sparkfunX/MicroMod_Thing_Plus/Hardware/Production/ordering_instructions.txt

panel size, 205x131mm
PCB thickness, 1.6mm
number of layers, 4
soldermask color, Black
silkscreen color, White
oz copper, 1oz
finish, HASL lead free
stencils, none
pcs per panel, 10
min trace width, 0.1778mm / 0.0070in
min drill size, 0.3048mm / 0.0120in
filename to layer stackup 1/2/3/4: GTL, GL2, GL3, GBL
