sparkfunX/MicroMod_Thing_Plus/Hardware/Jig/ThingPlus_Micromod-BottomJig.brd

## EAGLE design Hardware/Jig/ThingPlus_Micromod-BottomJig.brd (2021-07-26)

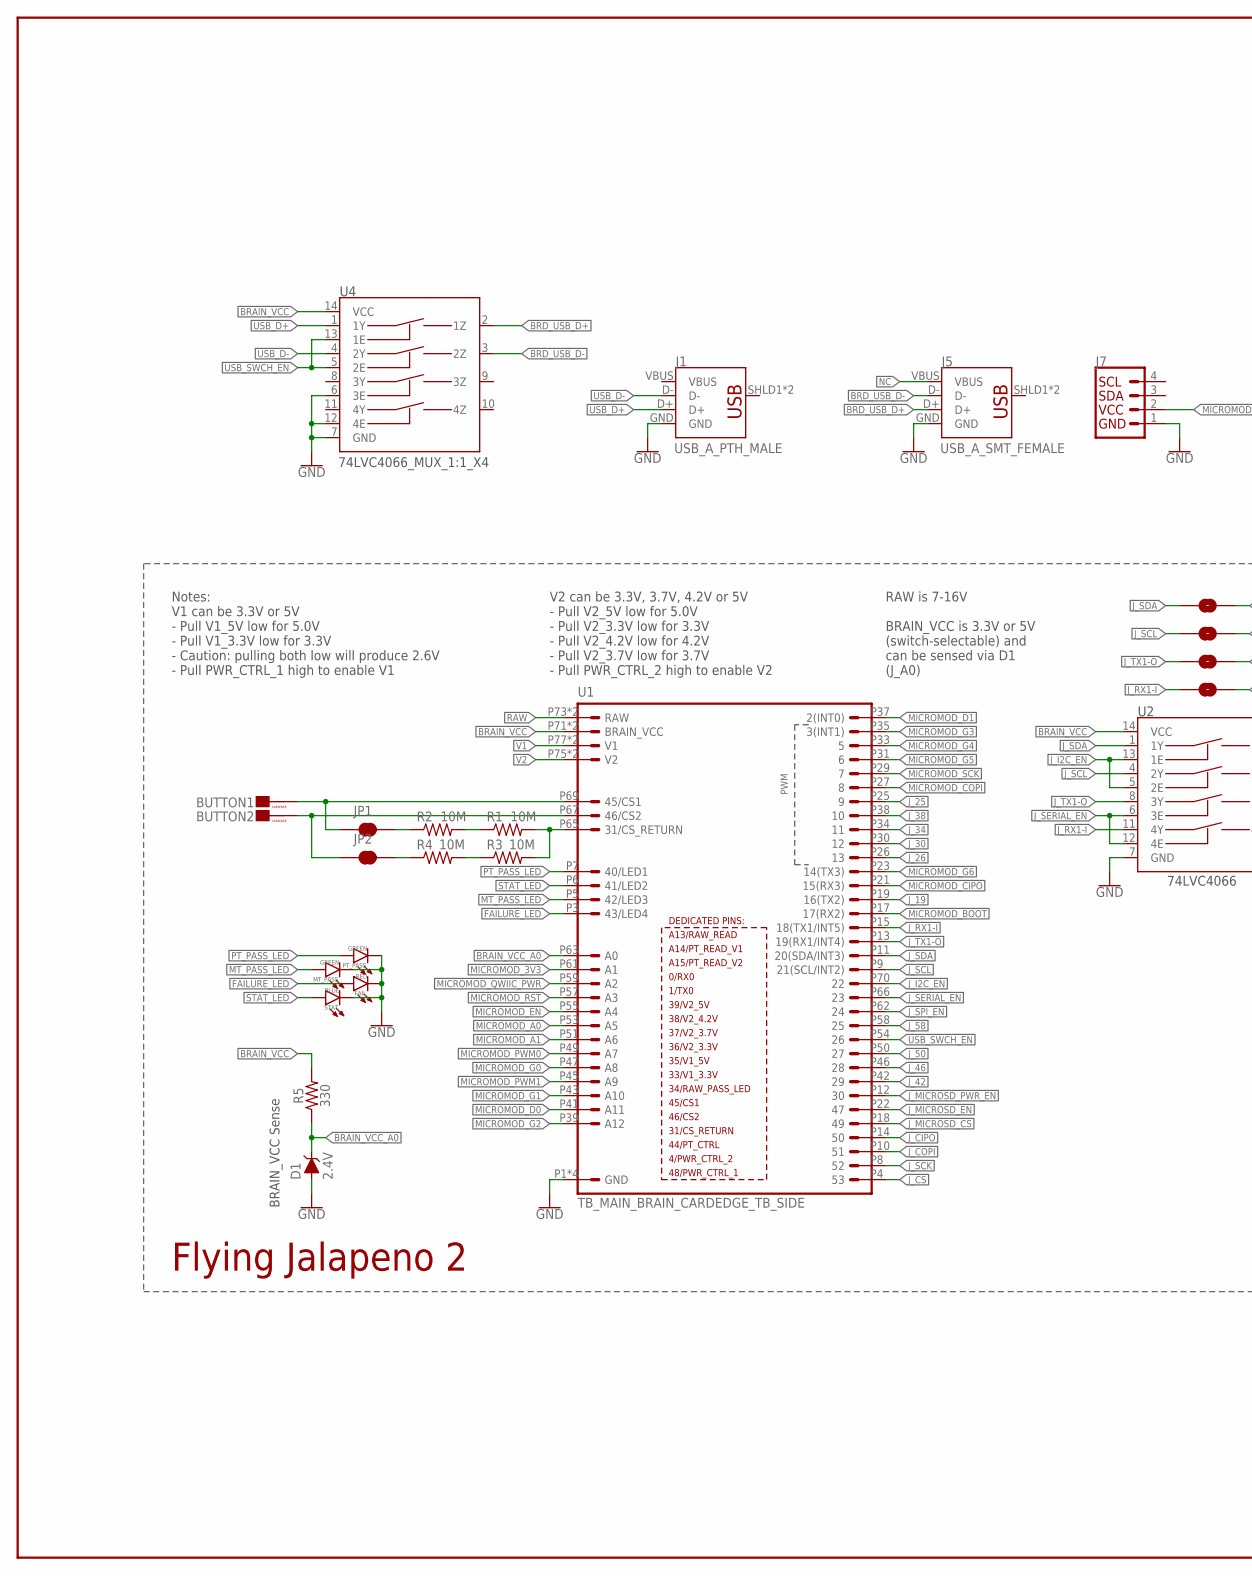
[picture p1: schematic ThingPlus_Micromod-BottomJig.sch, part in row 1, column 1]

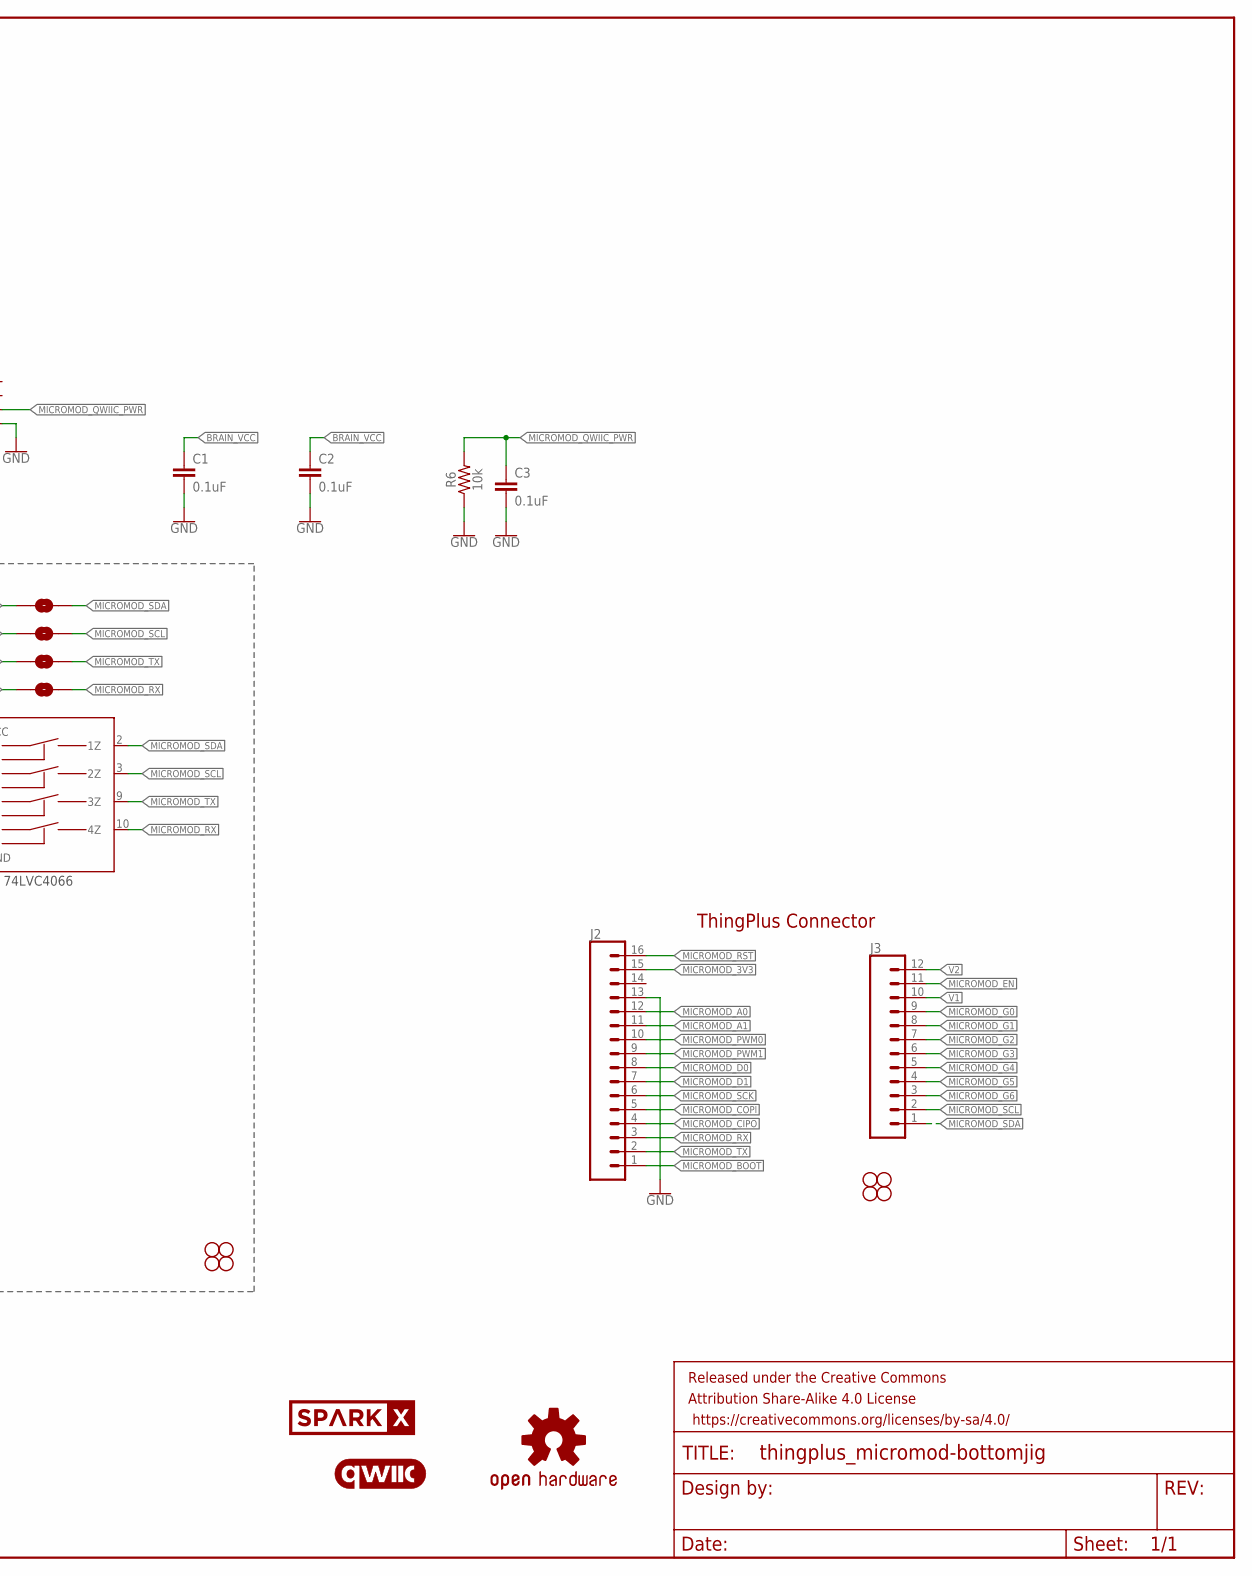
[picture p2: schematic ThingPlus_Micromod-BottomJig.sch, part in row 1, column 2]

Parts:
BUTTON1, BUTTON2: CAPSENSE_BUTTON_PAD_ONLYV2_SMALL; CAPSENSE_BUTTON_PAD_ONLY_SM
C1, C2, C3: 0.1uF; 0603
D1: 2.4V; SOD-323
FAIL: RED; LED-1206
FRAME2: FRAME-LEDGER; CREATIVE_COMMONS
H1, H2, H3, H4, H5, H6, H7, H8: STAND-OFF
J1: USB_A_PTH_MALE; USB-A-H
J2: CONN_161X16_SM_SQ_NOSILK; 1X16_SM_SQ_NOSILK
J3: CONN_12SM_SQ_NO_SILK; 1X12_SM_SQ_NOSILK
J5: USB_A_SMT_FEMALE; USB-A-S-SILK-FEMALE
J7: QWIIC_RIGHT_ANGLE; JST04_1MM_RA
JP1, JP2: JUMPER-SMT_2_NC_TRACE_SILK; SMT-JUMPER_2_NC_TRACE_SILK
J_SCL, J_SCL1, J_SCL2: JUMPER-SMT_2_NO_SILK; SMT-JUMPER_2_NO_SILK
J_SDA: JUMPER-SMT_2_NO_SILK; SMT-JUMPER_2_NO_SILK
LOGO2: OSHW-LOGOMINI; OSHW-LOGO-MINI
LOGO4: QWIIC_LOGO_4MM; QWIIC_4MM
MT_PASS: GREEN; LED-1206
PT_PASS: GREEN; LED-1206
R1, R2, R3, R4: 10M; 0603
R5: 330; 0603
R6: 10k; 0603
STAT: BLUE; LED-1206
U1: TB_MAIN_BRAIN_CARDEDGE_TB_SIDE; TB_CARDEDGE
U2: 74LVC4066; SO14
U4: 74LVC4066_MUX_1:1_X4; SO14
U$1: SPARKX-LOGO4; SPARKX-MEDIUM

Connections:
!MICROMOD_BOOT!: J2.1, U1.P17 (17(RX2))
!MICROMOD_RST!: J2.16, U1.P57 (A3)
BRAIN_VCC: C1.1, C2.1, R5.2, U1.P71 (BRAIN_VCC), U1.P72 (BRAIN_VCC), U2.14 (VCC), U4.14 (VCC)
BRAIN_VCC_A0: D1.C, R5.1, U1.P63 (A0)
BRD_USB_D+: J5.D+, U4.2 (1Z)
BRD_USB_D-: J5.D-, U4.3 (2Z)
FAILURE_LED: FAIL.A, U1.P3 (43/LED4)
GND: C1.2, C2.2, C3.2, D1.A, FAIL.C, J1.GND, J2.13, J5.GND, J7.1, MT_PASS.C, PT_PASS.C, R6.1, STAT.C, U1.P1 (GND), U1.P2 (GND), U1.P79 (GND), U1.P80 (GND), U2.7 (GND), U4.6 (3E), U4.7 (GND), U4.12 (4E)
J_19: U1.P19 (16(TX2))
J_25: U1.P25 (9)
J_26: U1.P26 (13)
J_30: U1.P30 (12)
J_34: U1.P34 (11)
J_38: U1.P38 (10)
J_42: U1.P42 (29)
J_46: U1.P46 (28)
J_50: U1.P50 (27)
J_58: U1.P58 (25)
J_CIPO: U1.P14 (50)
J_COPI: U1.P10 (51)
J_CS: U1.P4 (53)
J_I2C_EN: U1.P70 (22), U2.5 (2E), U2.13 (1E)
J_MICROSD_!CS!: U1.P18 (49)
J_MICROSD_EN: U1.P22 (47)
J_MICROSD_PWR_EN: U1.P12 (30)
J_RX1-I: J_SDA.1, U1.P15 (18(TX1/INT5)), U2.11 (4Y)
J_SCK: U1.P8 (52)
J_SCL: J_SCL.1, U1.P9 (21(SCL/INT2)), U2.4 (2Y)
J_SDA: J_SCL2.1, U1.P11 (20(SDA/INT3)), U2.1 (1Y)
J_SERIAL_EN: U1.P66 (23), U2.6 (3E), U2.12 (4E)
J_SPI_EN: U1.P62 (24)
J_TX1-O: J_SCL1.1, U1.P13 (19(RX1/INT4)), U2.8 (3Y)
MICROMOD_3V3: J2.15, U1.P61 (A1)
MICROMOD_A0: J2.12, U1.P53 (A5)
MICROMOD_A1: J2.11, U1.P51 (A6)
MICROMOD_CIPO: J2.4, U1.P21 (15(RX3))
MICROMOD_COPI: J2.5, U1.P27 (8)
MICROMOD_D0: J2.8, U1.P41 (A11)
MICROMOD_D1: J2.7, U1.P37 (2(INT0))
MICROMOD_EN: J3.11, U1.P55 (A4)
MICROMOD_G0: J3.9, U1.P47 (A8)
MICROMOD_G1: J3.8, U1.P43 (A10)
MICROMOD_G2: J3.7, U1.P39 (A12)
MICROMOD_G3: J3.6, U1.P35 (3(INT1))
MICROMOD_G4: J3.5, U1.P33 (5)
MICROMOD_G5: J3.4, U1.P31 (6)
MICROMOD_G6: J3.3, U1.P23 (14(TX3))
MICROMOD_PWM0: J2.10, U1.P49 (A7)
MICROMOD_PWM1: J2.9, U1.P45 (A9)
MICROMOD_QWIIC_PWR: C3.1, J7.2, R6.2, U1.P59 (A2)
MICROMOD_RX: J2.3, J_SDA.2, U2.10 (4Z)
MICROMOD_SCK: J2.6, U1.P29 (7)
MICROMOD_SCL: J3.2, J_SCL.2, U2.3 (2Z)
MICROMOD_SDA: J3.1, J_SCL2.2, U2.2 (1Z)
MICROMOD_TX: J2.2, J_SCL1.2, U2.9 (3Z)
MT_PASS_LED: MT_PASS.A, U1.P5 (42/LED3)
unnamed: R1.2, R3.2, U1.P65 (31/CS_RETURN)
unnamed: R1.1, R2.2
unnamed: BUTTON1.CAPSENSE_PAD, JP1.1, U1.P69 (45/CS1)
unnamed: R3.1, R4.2
unnamed: JP2.2, R4.1
unnamed: BUTTON2.CAPSENSE_PAD, JP2.1, U1.P67 (46/CS2)
unnamed: JP1.2, R2.1
NC: J5.VBUS
PT_PASS_LED: PT_PASS.A, U1.P7 (40/LED1)
RAW: U1.P73 (RAW), U1.P74 (RAW)
STAT_LED: STAT.A, U1.P6 (41/LED2)
USB_D+: J1.D+, U4.1 (1Y)
USB_D-: J1.D-, U4.4 (2Y)
USB_SWCH_EN: U1.P54 (26), U4.5 (2E), U4.13 (1E)
V1: J3.10, U1.P77 (V1), U1.P78 (V1)
V2: J3.12, U1.P75 (V2), U1.P76 (V2)
VBUS: J1.VBUS

Notes on the sheet:
ThingPlus Connector
Flying Jalapeno 2
Notes: V1 can be 3.3V or 5V - Pull V1_5V low for 5.0V - Pull V1_3.3V low for 3.3V - Caution: pulling both low will produce 2.6V - Pull PWR_CTRL_1 high to enable V1
V2 can be 3.3V, 3.7V, 4.2V or 5V - Pull V2_5V low for 5.0V - Pull V2_3.3V low for 3.3V - Pull V2_4.2V low for 4.2V - Pull V2_3.7V low for 3.7V - Pull PWR_CTRL_2 high to enable V2
RAW is 7-16V BRAIN_VCC is 3.3V or 5V (switch-selectable) and can be sensed via D1 (J_A0)
BRAIN_VCC Sense

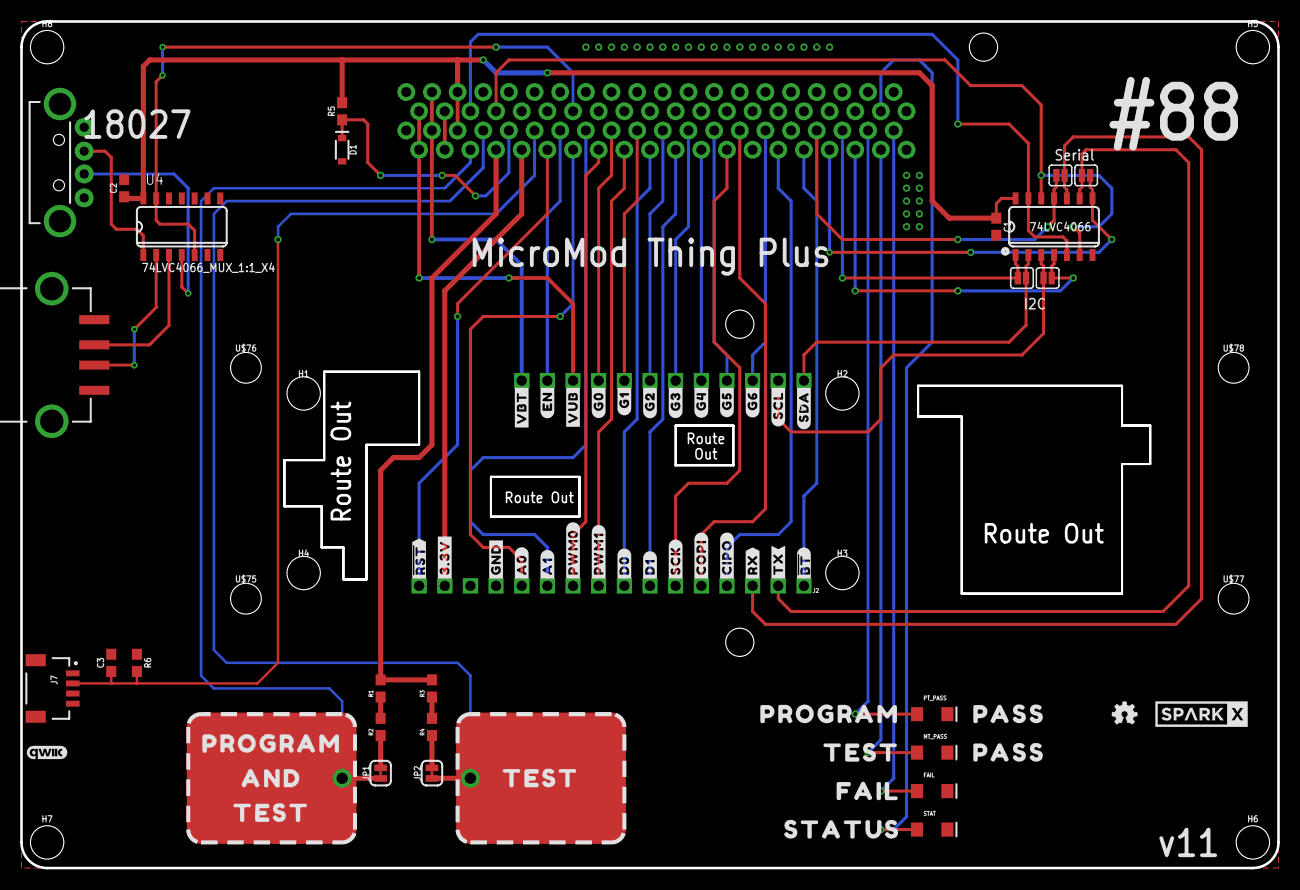
[picture p3: board ThingPlus_Micromod-BottomJig.brd from above]

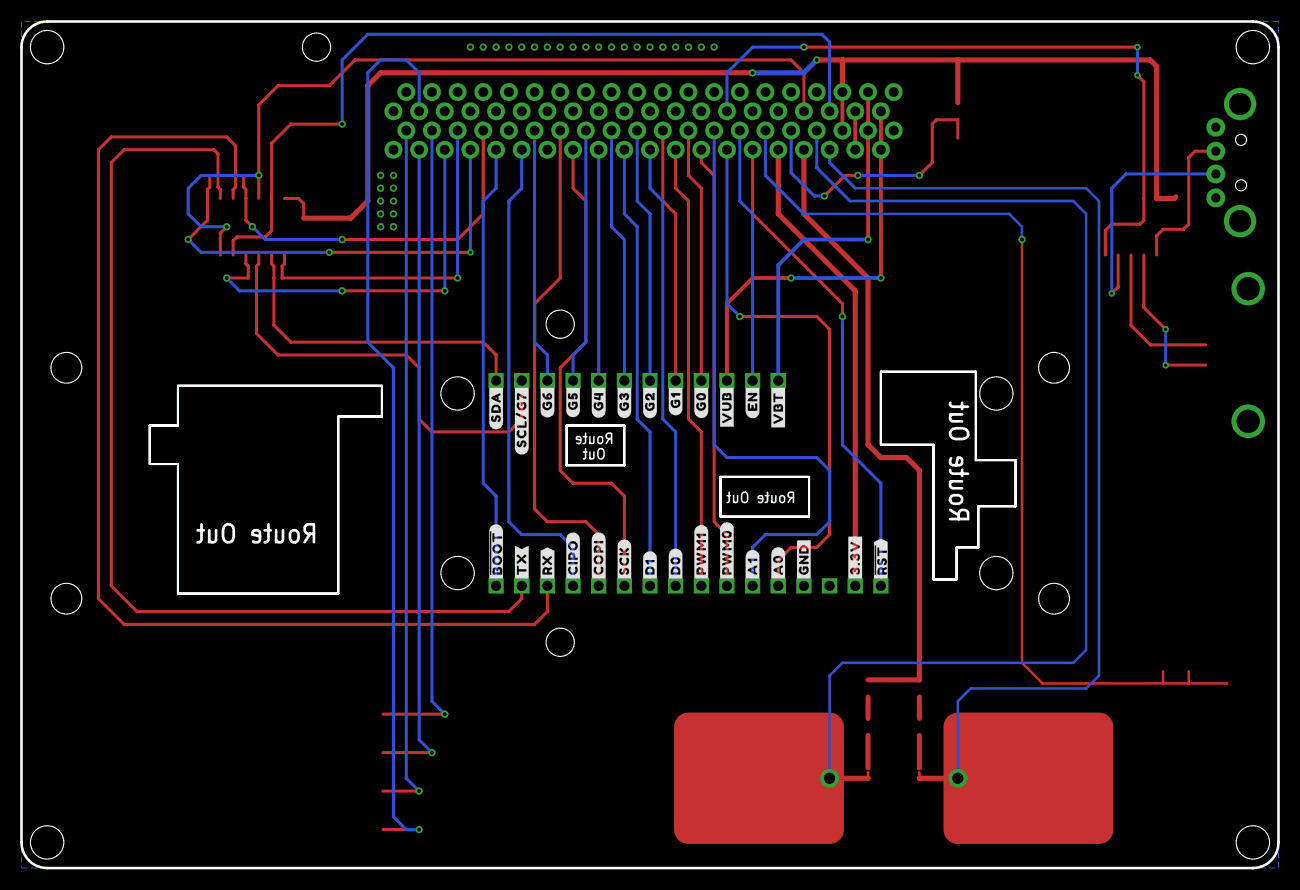
[picture p4: board ThingPlus_Micromod-BottomJig.brd from below]

Board: 2 copper layers, 124.5 x 83.8 mm, 112 parts (27 on the bottom side), 53 nets.

Other parts of the board:
U$3: ##BT##11
U$4, U$42: #TX#9
U$5, U$43: #RX#8
U$6, U$44: #CIPO#7
U$7, U$45: #COPI#6
U$8, U$46: #SCK#5
U$9, U$47: #D1#5
U$10, U$48: #D0#5
U$11, U$49: #PWM0#5
U$12, U$50: #PWM1#5
U$13, U$51: #A1#5
U$14, U$52: #A0#5
U$15, U$53: #GND#4
U$16, U$54: #3#3V#1
U$17, U$55: ##RST##0
U$22, U$57: #VBT#16
U$23, U$58: #EN#15
U$24, U$59: #G0#14
U$25, U$60: #G1#14
U$26, U$61: #G2#14
U$27, U$62: #G3#14
U$28, U$63: #G4#14
U$29, U$64: #G5#14
U$30, U$65: #G6#14
U$31: #SCL#13
U$32, U$67: #SDA#12
U$35, U$68: #VUB#15
U$56: ##BOOT##10
U$71: #SCL#G7#14
U$75, U$76, U$77, U$78: STAND-OFF-TIGHT
U$79, U$80: NUBBIN_LOCKER
U$82, U$83: PROGRAM0
U$84: AND0
U$85, U$86, U$87: TEST0
U$88, U$89: PASS0
U$90: FAIL0
U$91: STATUS0
