sparkfunX/MicroMod_Thing_Plus/Hardware/ThingPlus_Micromod.brd

## EAGLE design Hardware/ThingPlus_Micromod.brd (2021-02-11)

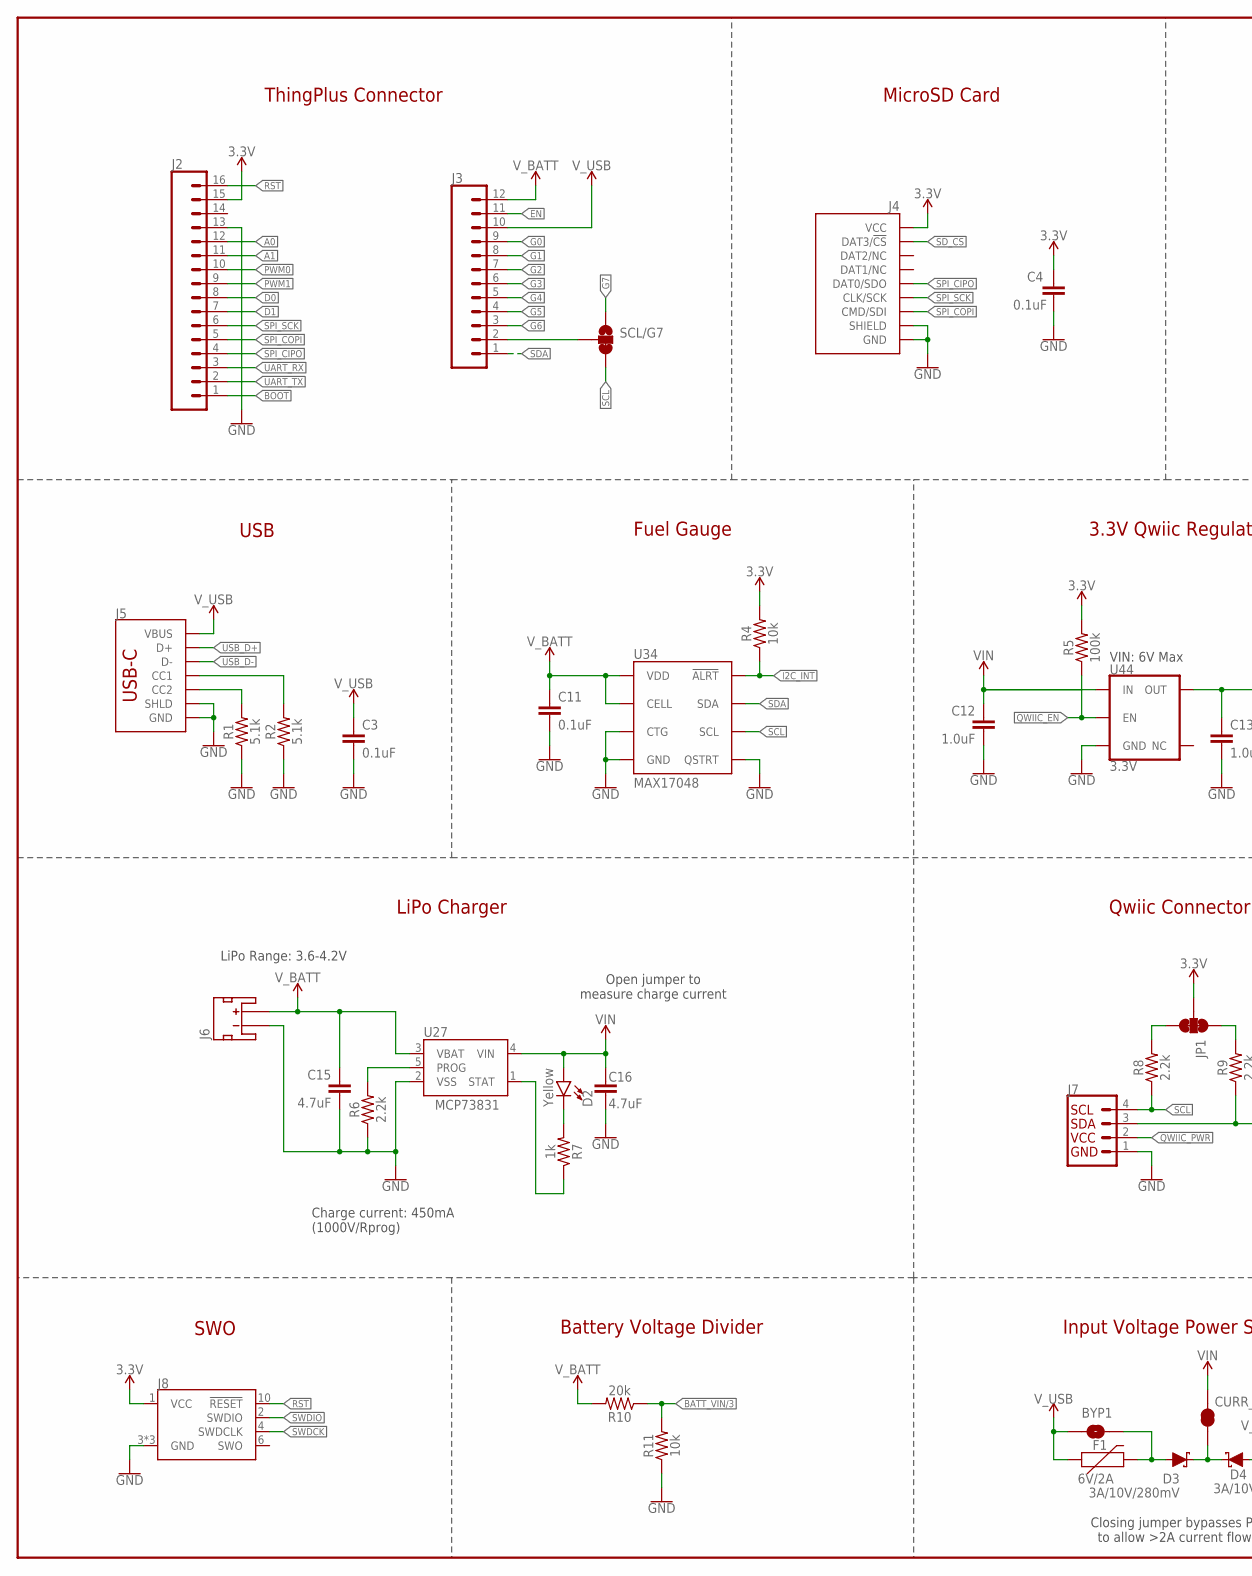
[picture p5: schematic ThingPlus_Micromod.sch, part in row 1, column 1]

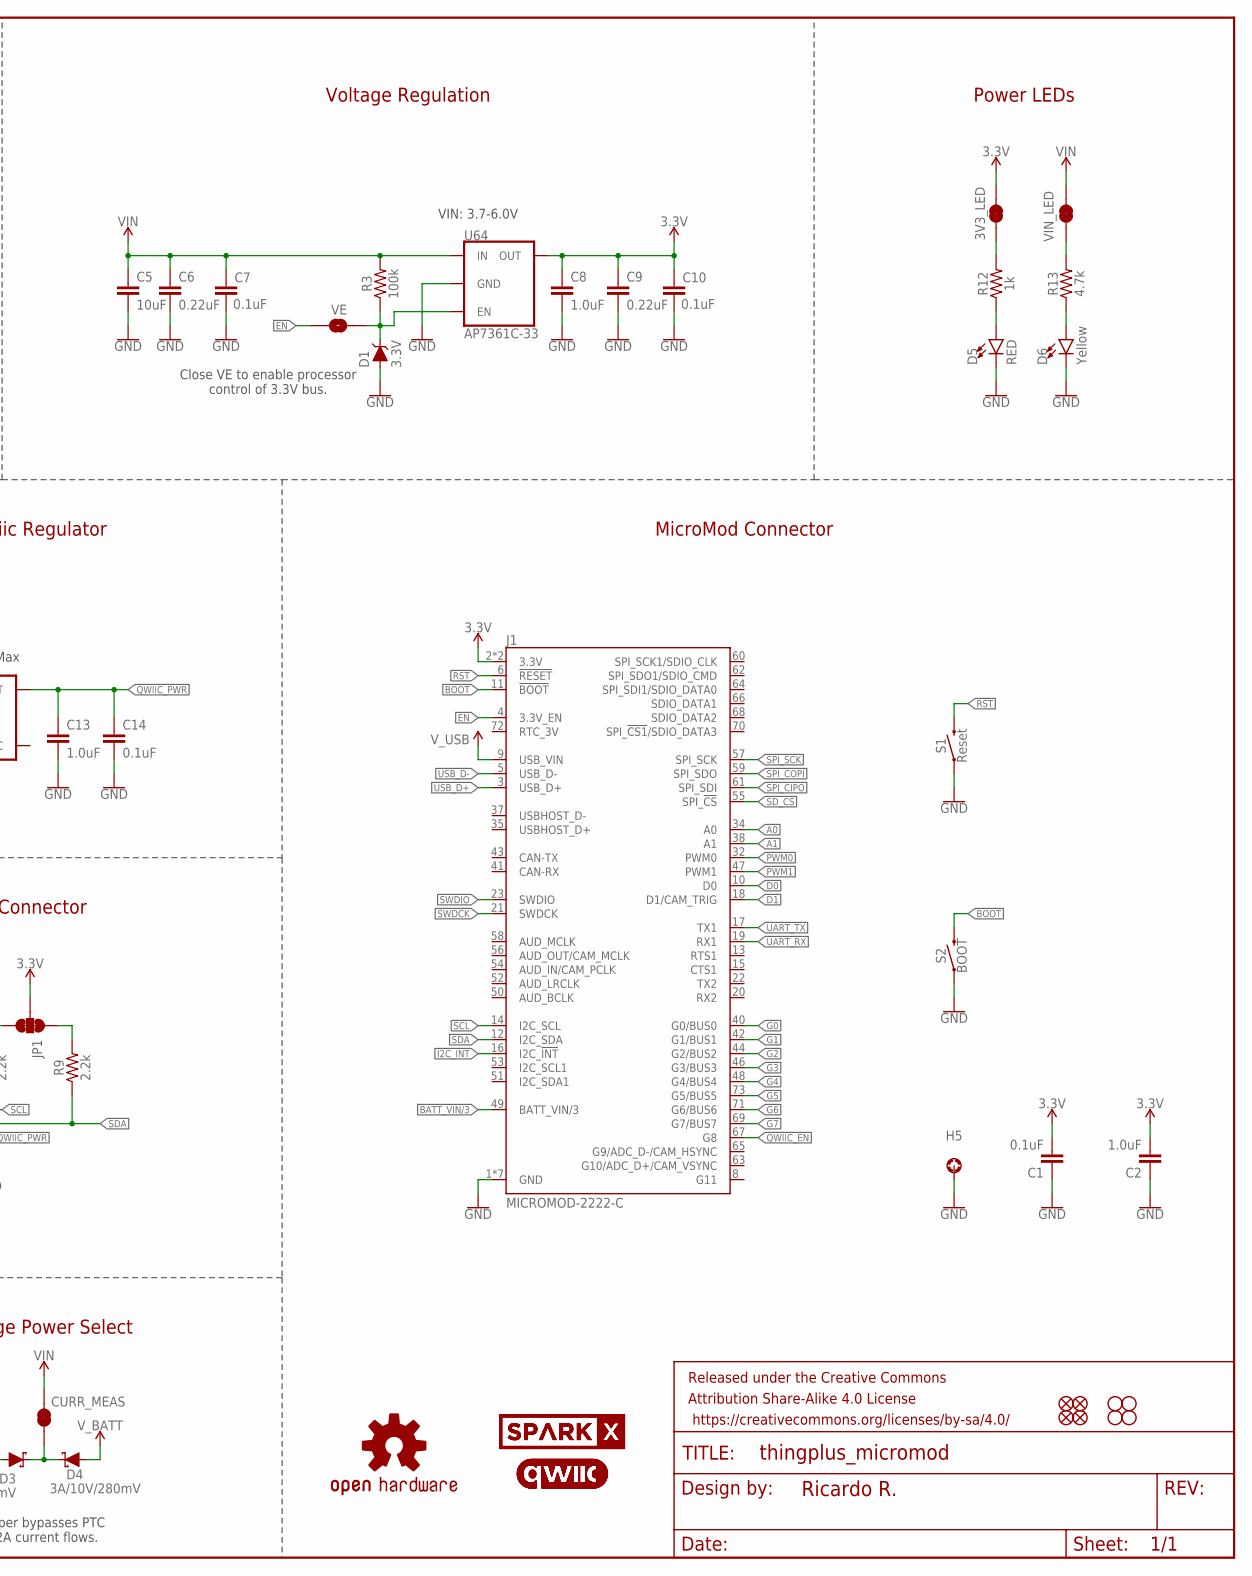
[picture p6: schematic ThingPlus_Micromod.sch, part in row 1, column 2]

Parts:
3V3_LED: JUMPER-SMT_2_NC_TRACE_SILK; SMT-JUMPER_2_NC_TRACE_SILK
BYP1: JUMPER-SMT_2_NO_SILK; SMT-JUMPER_2_NO_SILK
C1, C3, C4, C7, C10, C11, C14: 0.1uF; 0603
C2, C8, C12, C13: 1.0uF; 0603
C5: 10uF; 0805
C6, C9: 0.22uF; 0603
C15, C16: 4.7uF; 0603
CURR_MEAS: JUMPER-COMBO_2_NC_TRACE; COMBO-JUMPER_2_NC_TRACE
D1: 3.3V; SOD-323
D2, D6: Yellow; LED-0603
D3, D4: 3A/10V/280mV; SOD-323
D5: RED; LED-0603
F1: 6V/2A; 1210
FD1, FD2, FD3, FD4: FIDUCIALUFIDUCIAL; FIDUCIAL-MICRO
FRAME1: FRAME-LEDGER; CREATIVE_COMMONS
H1, H2, H3, H4: STAND-OFF
H5: STAND-OFF-REFLOW2.5MM_TALL; STAND-OFF-REFLOW-M2.5
J1: MICROMOD-2222-C; M.2-CONNECTOR-E
J2: CONN_161X16_SM_SQ_NOSILK; 1X16_SM_SQ_NOSILK
J3: CONN_12SM_SQ_NO_SILK; 1X12_SM_SQ_NOSILK
J4: MICRO-SD-SDIOPUSH-PUSH; MICRO-SD-SOCKET
J5: USB_C_4-LAYER_PADS; USB-C-16P_4LAYER-PADS
J6: JST_2MM_MALE; JST-2-SMD
J7: QWIIC_RIGHT_ANGLE; JST04_1MM_RA
J8: JTAG; 2X5-PTH-1.27MM
JP1: JUMPER-SMT_3_2-NC_TRACE_SILK; SMT-JUMPER_3_2-NC_TRACE_SILK
LOGO1: OSHW-LOGOMINI; OSHW-LOGO-MINI
LOGO2, LOGO3: QWIIC_LOGO_4MM; QWIIC_4MM
R1, R2: 5.1k; 0603
R3, R5: 100k; 0603
R4, R11: 10k; 0603
R6, R8, R9: 2.2k; 0603
R7, R12: 1k; 0603
R10: 20k; 0603
R13: 4.7k; 0603
S1: Reset; TACTILE_SWITCH_SMD_5.2MM
S2: BOOT; TACTILE_SWITCH_SMD_5.2MM
SCL/G7: JUMPER-SMT_3_1-NC_TRACE_SILK; SMT-JUMPER_3_1-NC_TRACE_SILK
U27: MCP73831; SOT23-5
U34: MAX17048; DFN-8
U44: 3.3V; SOT23-5
U64: AP7361C-33; UDFN-8
U$1, U$2: SPARKX-LOGO5; SPARKX-LARGE
VE: JUMPER-SMT_2_NO_SILK; SMT-JUMPER_2_NO_SILK
VIN_LED: JUMPER-SMT_2_NC_TRACE_SILK; SMT-JUMPER_2_NC_TRACE_SILK

Connections:
3.3V: 3V3_LED.2, C1.2, C2.2, C4.1, C8.1, C9.1, C10.1, J1.2 (3.3V), J1.74 (3.3V), J2.15, J4.VCC, J8.1 (VCC), JP1.2, R4.2, R5.2, U64.1 (OUT)
3.3V_EN_VE: D1.C, R3.1, U64.5 (EN), VE.2
!BOOT!: J1.11 (!BOOT!), J2.1, S2.3 (2), S2.4 (2)
!I2C_INT!: J1.16 (I2C_!INT!), R4.1, U34.5 (!ALRT)
!RST!: J1.6 (!RESET!), J2.16, J8.10 (!RESET), S1.3 (2), S1.4 (2)
!SD_CS!: J1.55 (SPI_!CS!), J4.CS/DAT3 (DAT3/!CS!)
A0: J1.34 (A0), J2.12
A1: J1.38 (A1), J2.11
BATT_VIN/3: J1.49 (BATT_VIN/3), R10.1, R11.2
CHG_LED: R7.1, U27.1 (STAT)
D0: J1.10 (D0), J2.8
D1: J1.18 (D1/CAM_TRIG), J2.7
EN: J1.4 (3.3V_EN), J3.11, VE.1
G0: J1.40 (G0/BUS0), J3.9
G1: J1.42 (G1/BUS1), J3.8
G2: J1.44 (G2/BUS2), J3.7
G3: J1.46 (G3/BUS3), J3.6
G4: J1.48 (G4/BUS4), J3.5
G5: J1.73 (G5/BUS5), J3.4
G6: J1.71 (G6/BUS6), J3.3
G7: J1.69 (G7/BUS7), SCL/G7.1
GND: C1.1, C2.1, C3.2, C4.2, C5.2, C6.2, C7.2, C8.2, C9.2, C10.2, C11.2, C12.2, C13.2, C14.2, C15.2, C16.2, D1.A, D5.C, D6.C, H5.1, J1.1 (GND), J1.7 (GND), J1.33 (GND), J1.36 (GND), J1.39 (GND), J1.45 (GND), J1.75 (GND), J2.13, J4.CD1 (SHIELD), J4.GND, J4.GND1 (GND), J4.GND3 (GND), J5.GND, J5.GND2 (GND), J5.SHLD1 (SHLD), J5.SHLD2 (SHLD), J5.SHLD3 (SHLD), J5.SHLD4 (SHLD), J6.1 (-), J7.1, J8.3 (GND), J8.5 (GND), J8.9 (GND), R1.1, R2.1, R6.1, R11.1, S1.1, S1.2 (1), S2.1, S2.2 (1), U27.2 (VSS), U34.1 (CTG), U34.4 (GND), U34.6 (QSTRT), U34.9 (GND), U44.2 (GND), U64.4 (GND), U64.EP (GND)
unnamed: JP1.3, R8.2
unnamed: JP1.1, R9.2
unnamed: BYP1.2, D3.A, F1.2
unnamed: CURR_MEAS.1, CURR_MEAS.3 (1), D3.C, D4.C
unnamed: 3V3_LED.1, R12.2
unnamed: R6.2, U27.5 (PROG)
unnamed: D5.A, R12.1
unnamed: R13.2, VIN_LED.1
unnamed: D6.A, R13.1
unnamed: J5.A5 (CC1), R2.2
unnamed: J5.B5 (CC2), R1.2
unnamed: D2.C, R7.2
PWM0: J1.32 (PWM0), J2.10
PWM1: J1.47 (PWM1), J2.9
QWIIC_EN: J1.67 (G8), R5.1, U44.3 (EN)
QWIIC_PWR: C13.1, C14.1, J7.2, U44.5 (OUT)
SCL: J1.14 (I2C_SCL), J7.4, R8.1, SCL/G7.3, U34.7 (SCL)
SCL/G7: J3.2, SCL/G7.2
SDA: J1.12 (I2C_SDA), J3.1, J7.3, R9.1, U34.8 (SDA)
SPI_CIPO: J1.61 (SPI_SDI), J2.4, J4.DO/DAT0 (DAT0/SDO)
SPI_COPI: J1.59 (SPI_SDO), J2.5, J4.DI/CMD (CMD/SDI)
SPI_SCK: J1.57 (SPI_SCK), J2.6, J4.SCLK (CLK/SCK)
SWDCK: J1.21 (SWDCK), J8.4 (SWDCLK)
SWDIO: J1.23 (SWDIO), J8.2 (SWDIO)
UART_RX: J1.19 (RX1), J2.3
UART_TX: J1.17 (TX1), J2.2
USB_D+: J1.3 (USB_D+), J5.A6 (D+), J5.B6 (D+)
USB_D-: J1.5 (USB_D-), J5.A7 (D-), J5.B7 (D-)
VIN: C5.1, C6.1, C7.1, C12.1, C16.1, CURR_MEAS.2, CURR_MEAS.4 (2), D2.A, R3.2, U27.4 (VIN), U44.1 (IN), U64.8 (IN), VIN_LED.2
V_BATT: C11.1, C15.1, D4.A, J3.12, J6.2 (+), R10.2, U27.3 (VBAT), U34.2 (CELL), U34.3 (VDD)
V_USB: BYP1.1, C3.1, F1.1, J1.9 (USB_VIN), J3.10, J5.VBUS1 (VBUS), J5.VBUS2 (VBUS)

Notes on the sheet:
VIN: 6V Max
Fuel Gauge
3.3V Qwiic Regulator
Input Voltage Power Select
Qwiic Connector
Battery Voltage Divider
MicroSD Card
ThingPlus Connector
Voltage Regulation
Closing jumper bypasses PTC to allow >2A current flows.
VIN: 3.7-6.0V
Close VE to enable processor control of 3.3V bus.
USB
LiPo Charger
LiPo Range: 3.6-4.2V
Charge current: 450mA (1000V/Rprog)
Open jumper to measure charge current
SWO
MicroMod Connector
Power LEDs

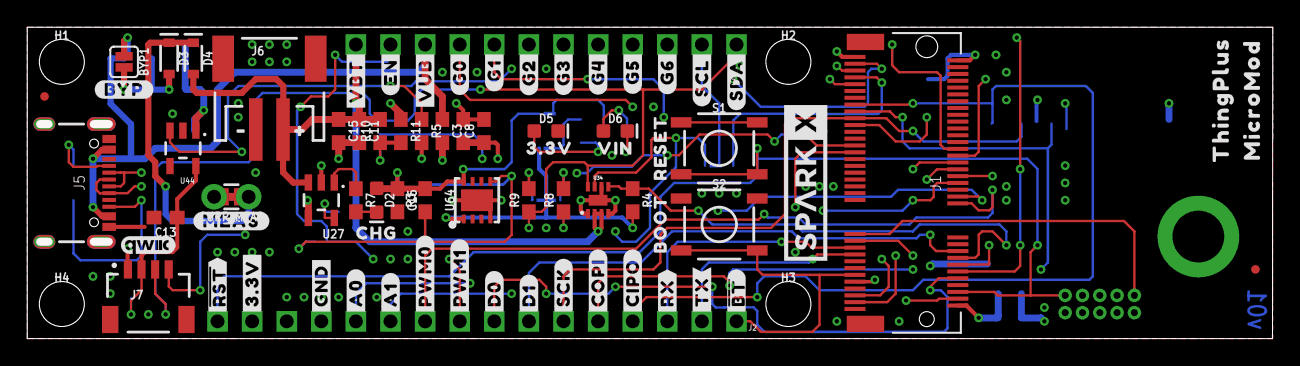
[picture p7: board ThingPlus_Micromod.brd from above]

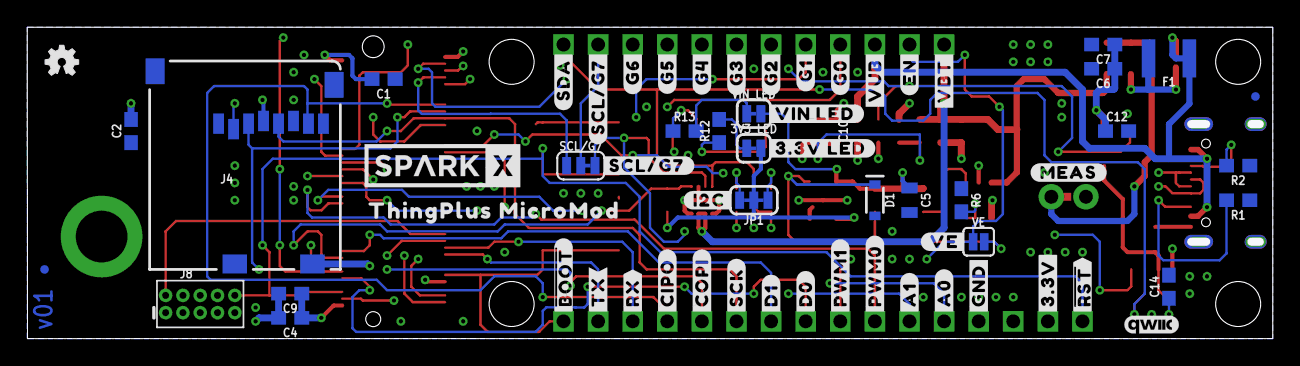
[picture p8: board ThingPlus_Micromod.brd from below]

Board: 4 copper layers, 91.4 x 22.9 mm, 144 parts (62 on the bottom side), 53 nets.

Other parts of the board:
U$3: ##BT##11
U$4, U$42: #TX#9
U$5, U$43: #RX#8
U$6, U$44: #CIPO#7
U$7, U$45: #COPI#6
U$8, U$46: #SCK#5
U$9, U$47: #D1#5
U$10, U$48: #D0#5
U$11, U$49: #PWM0#5
U$12, U$50: #PWM1#5
U$13, U$51: #A1#5
U$14, U$52: #A0#5
U$15, U$53: #GND#4
U$16, U$54: #3#3V#1
U$17, U$55: ##RST##0
U$18, U$66: #MEAS#25
U$19: CHG20
U$20: RESET19
U$21: BOOT18
U$22, U$57: #VBT#16
U$23, U$58: #EN#15
U$24, U$59: #G0#14
U$25, U$60: #G1#14
U$26, U$61: #G2#14
U$27, U$62: #G3#14
U$28, U$63: #G4#14
U$29, U$64: #G5#14
U$30, U$65: #G6#14
U$31: #SCL#13
U$32, U$67: #SDA#12
U$33: 3#3V22
U$34: VIN21
U$35, U$68: #VUB#15
U$36: THINGPLUS29
U$37: MICROMOD30
U$38: #31
U$39: #33
U$40: #BYP#27
U$41: #VE#16
U$56: ##BOOT##10
U$69: #3#3V_LED#25
U$70: #VIN_LED#25
U$71: #SCL#G7#14
U$72: #I2C#27
U$73: THINGPLUS_MICROMOD29
U$74: #SCL#G7#27
