sparkfunX/MicroMod_Thing_Plus/Hardware/Production/ThingPlus_Micromod-Panel.brd

## EAGLE design Hardware/Production/ThingPlus_Micromod-Panel.brd (2021-03-24)

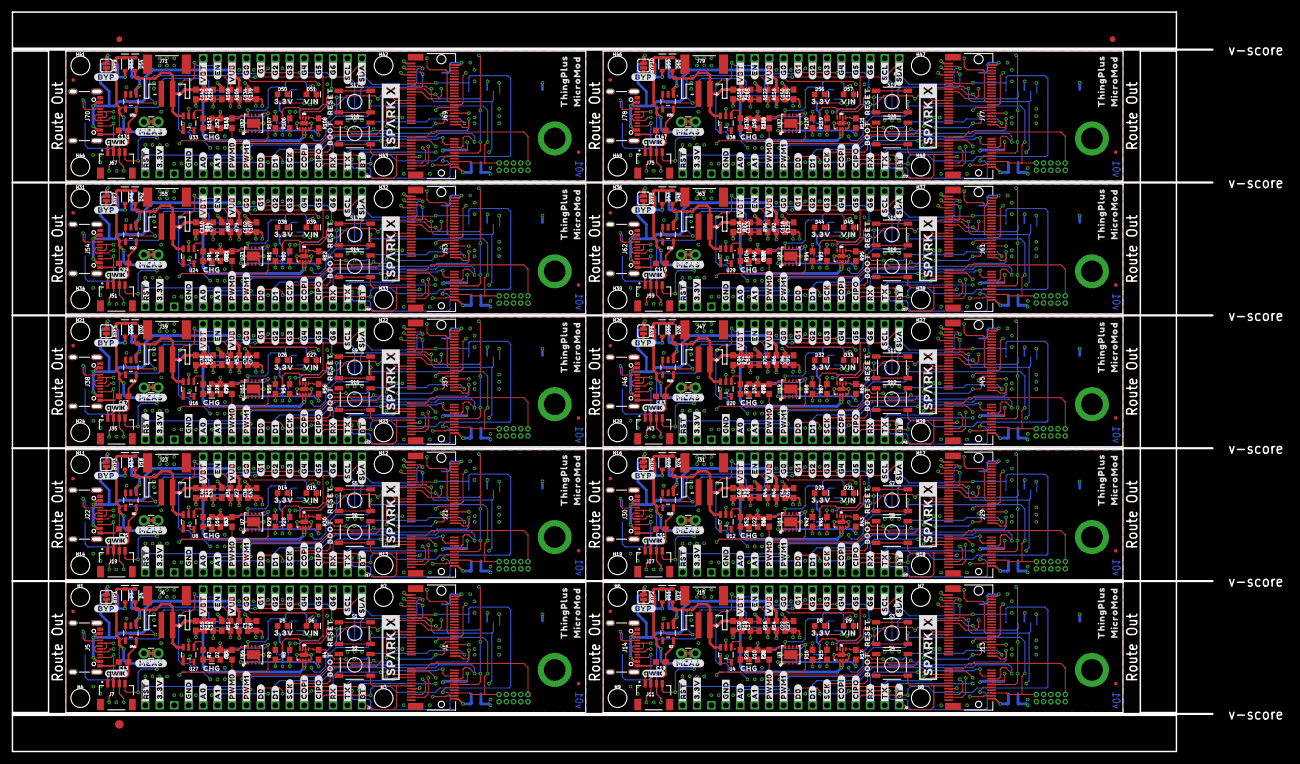
[picture p9: board ThingPlus_Micromod-Panel.brd from above]

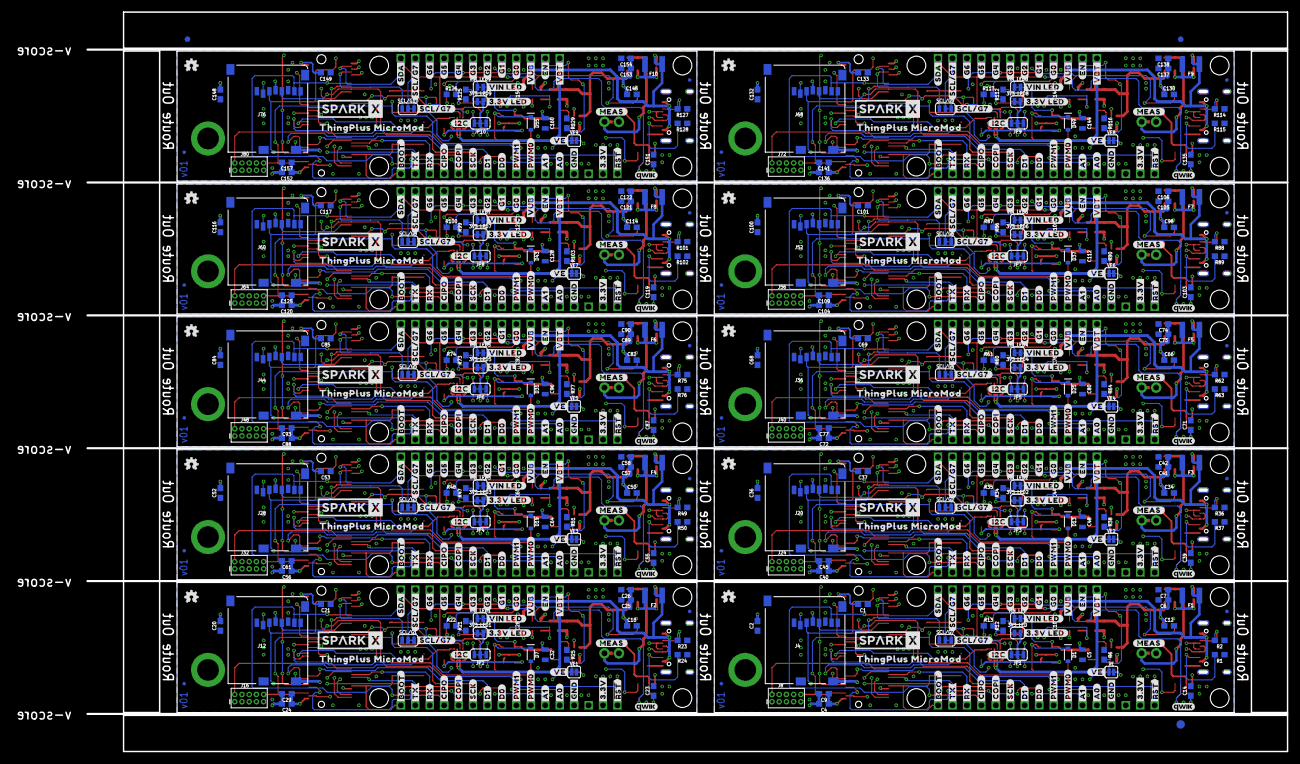
[picture p10: board ThingPlus_Micromod-Panel.brd from below]

Board: 4 copper layers, 211.1 x 130.0 mm, 1446 parts (623 on the bottom side), 530 nets.

Parts:
3V3_LED, 3V3_LED1, 3V3_LED2, 3V3_LED3, 3V3_LED4, 3V3_LED5, 3V3_LED6, 3V3_LED7, 3V3_LED8, 3V3_LED9: SMT-JUMPER_2_NC_TRACE_SILK
BYP1, BYP2, BYP3, BYP4, BYP5, BYP6, BYP7, BYP8, BYP9, BYP10: JUMPER-SMT_2_NO_SILK; SMT-JUMPER_2_NO_SILK
C1, C3, C4, C7, C10, C11, C14, C17, C21, C22, C23, C24, C26, C28, C33, C37, C38, C39, C40, C42, C44, C49, C53, C54, C55, C56, C58, C60, C65, C69, C70, C71, C72, C74, C76, C81, C85, C86, C87, C88, C90, C92, C97, C101, C102, C103, C104, C106, C108, C113, C117, C118, C119, C120, C122, C124, C129, C133, C134, C135, C136, C138, C140, C145, C149, C150, C151, C152, C154, C156: 0.1uF; 0603
C2, C8, C12, C13, C18, C19, C20, C27, C34, C35, C36, C43, C50, C51, C52, C59, C66, C67, C68, C75, C82, C83, C84, C91, C98, C99, C100, C107, C114, C115, C116, C123, C130, C131, C132, C139, C146, C147, C148, C155: 1.0uF; 0603
C5, C32, C48, C64, C80, C96, C112, C128, C144, C160: 10uF; 0805
C6, C9, C25, C29, C41, C45, C57, C61, C73, C77, C89, C93, C105, C109, C121, C125, C137, C141, C153, C157: 0.22uF; 0603
C15, C16, C30, C31, C46, C47, C62, C63, C78, C79, C94, C95, C110, C111, C126, C127, C142, C143, C158, C159: 4.7uF; 0603
CURR_MEAS, CURR_MEAS1, CURR_MEAS2, CURR_MEAS3, CURR_MEAS4, CURR_MEAS5, CURR_MEAS6, CURR_MEAS7, CURR_MEAS8, CURR_MEAS9: COMBO-JUMPER_2_NC_TRACE
D1, D7, D13, D19, D25, D31, D37, D43, D49, D55: 3.3V; SOD-323
D2, D6, D9, D10, D15, D16, D21, D22, D27, D28, D33, D34, D39, D40, D45, D46, D51, D52, D57, D58: Yellow; LED-0603
D3, D4, D11, D12, D17, D18, D23, D24, D29, D30, D35, D36, D41, D42, D47, D48, D53, D54, D59, D60: 3A/10V/280mV; SOD-323
D5, D8, D14, D20, D26, D32, D38, D44, D50, D56: RED; LED-0603
E$1, E$2, E$3, E$4: FIDUCIAL-1X2
E$5, E$6: FIDUCIAL-1.5X3
F1, F2, F3, F4, F5, F6, F7, F8, F9, F10: 6V/2A; 1210
FD1, FD2, FD3, FD4, FD5, FD6, FD7, FD8, FD9, FD10, FD11, FD12, FD13, FD14, FD15, FD16, FD17, FD18, FD19, FD20, FD21, FD22, FD23, FD24, FD25, FD26, FD27, FD28, FD29, FD30, FD31, FD32, FD33, FD34, FD35, FD36, FD37, FD38, FD39, FD40: FIDUCIALUFIDUCIAL; FIDUCIAL-MICRO
FRAME1, FRAME2, FRAME3, FRAME4, FRAME5, FRAME6, FRAME7, FRAME8, FRAME9, FRAME10: FRAME-LEDGER; CREATIVE_COMMONS
H1, H2, H3, H4, H6, H7, H8, H9, H11, H12, H13, H14, H16, H17, H18, H19, H21, H22, H23, H24, H26, H27, H28, H29, H31, H32, H33, H34, H36, H37, H38, H39, H41, H42, H43, H44, H46, H47, H48, H49: STAND-OFF
H5, H10, H15, H20, H25, H30, H35, H40, H45, H50: STAND-OFF-REFLOW2.5MM_TALL; STAND-OFF-REFLOW-M2.5
J1, J13, J21, J29, J37, J45, J53, J61, J69, J77: MICROMOD-2222-C; M.2-CONNECTOR-E
J2, J9, J17, J25, J33, J41, J49, J57, J65, J73: 1X16_SM_SQ_NOSILK
J3, J10, J18, J26, J34, J42, J50, J58, J66, J74: 1X12_SM_SQ_NOSILK
J4, J12, J20, J28, J36, J44, J52, J60, J68, J76: MICRO-SD-SDIOPUSH-PUSH; MICRO-SD-SOCKET
J5, J14, J22, J30, J38, J46, J54, J62, J70, J78: USB-C-16P_4LAYER-PADS
J6, J15, J23, J31, J39, J47, J55, J63, J71, J79: JST-2-SMD
J7, J11, J19, J27, J35, J43, J51, J59, J67, J75: QWIIC_RIGHT_ANGLE; JST04_1MM_RA
J8, J16, J24, J32, J40, J48, J56, J64, J72, J80: JTAG; 2X5-PTH-1.27MM
JP1, JP2, JP3, JP4, JP5, JP6, JP7, JP8, JP9, JP10: JUMPER-SMT_3_2-NC_TRACE_SILK; SMT-JUMPER_3_2-NC_TRACE_SILK
LOGO1, LOGO4, LOGO7, LOGO10, LOGO13, LOGO16, LOGO19, LOGO22, LOGO25, LOGO28: OSHW-LOGOMINI; OSHW-LOGO-MINI
LOGO2, LOGO3, LOGO5, LOGO6, LOGO8, LOGO9, LOGO11, LOGO12, LOGO14, LOGO15, LOGO17, LOGO18, LOGO20, LOGO21, LOGO23, LOGO24, LOGO26, LOGO27, LOGO29, LOGO30: QWIIC_LOGO_4MM; QWIIC_4MM
R1, R2, R23, R24, R36, R37, R49, R50, R62, R63, R75, R76, R88, R89, R101, R102, R114, R115, R127, R128: 5.1k; 0603
R3, R5, R14, R20, R27, R33, R40, R46, R53, R59, R66, R72, R79, R85, R92, R98, R105, R111, R118, R124: 100k; 0603
R4, R11, R17, R18, R30, R31, R43, R44, R56, R57, R69, R70, R82, R83, R95, R96, R108, R109, R121, R122: 10k; 0603
R6, R8, R9, R15, R16, R25, R28, R29, R38, R41, R42, R51, R54, R55, R64, R67, R68, R77, R80, R81, R90, R93, R94, R103, R106, R107, R116, R119, R120, R129: 2.2k; 0603
R7, R12, R21, R26, R34, R39, R47, R52, R60, R65, R73, R78, R86, R91, R99, R104, R112, R117, R125, R130: 1k; 0603
R10, R19, R32, R45, R58, R71, R84, R97, R110, R123: 20k; 0603
R13, R22, R35, R48, R61, R74, R87, R100, R113, R126: 4.7k; 0603
S1, S3, S5, S7, S9, S11, S13, S15, S17, S19: Reset; TACTILE_SWITCH_SMD_5.2MM
S2, S4, S6, S8, S10, S12, S14, S16, S18, S20: BOOT; TACTILE_SWITCH_SMD_5.2MM
SCL/G1, SCL/G2, SCL/G3, SCL/G4, SCL/G5, SCL/G6, SCL/G7, SCL/G8, SCL/G9, SCL/G10: JUMPER-SMT_3_1-NC_TRACE_SILK; SMT-JUMPER_3_1-NC_TRACE_SILK
U1, U5, U9, U13, U17, U21, U25, U30, U34, U35: MAX17048; DFN-8
U2, U6, U10, U14, U18, U22, U26, U31, U36, U44: 3.3V; SOT23-5
U3, U7, U11, U15, U19, U23, U28, U32, U37, U64: AP7361C-33; UDFN-8
U4, U8, U12, U16, U20, U24, U27, U29, U33, U38: MCP73831; SOT23-5
U$1, U$2, U$75, U$76, U$149, U$150, U$223, U$224, U$297, U$298, U$371, U$372, U$445, U$446, U$519, U$520, U$593, U$594, U$667, U$668: SPARKX-LOGO5; SPARKX-LARGE
U$3, U$77, U$151, U$225, U$299, U$373, U$447, U$521, U$595, U$669: ##BT##11
U$4, U$42, U$78, U$114, U$152, U$188, U$226, U$262, U$300, U$336, U$374, U$410, U$448, U$484, U$522, U$558, U$596, U$632, U$670, U$706: #TX#9
U$5, U$43, U$79, U$115, U$153, U$189, U$227, U$263, U$301, U$337, U$375, U$411, U$449, U$485, U$523, U$559, U$597, U$633, U$671, U$707: #RX#8
U$6, U$44, U$80, U$116, U$154, U$190, U$228, U$264, U$302, U$338, U$376, U$412, U$450, U$486, U$524, U$560, U$598, U$634, U$672, U$708: #CIPO#7
U$7, U$45, U$81, U$117, U$155, U$191, U$229, U$265, U$303, U$339, U$377, U$413, U$451, U$487, U$525, U$561, U$599, U$635, U$673, U$709: #COPI#6
U$8, U$46, U$82, U$118, U$156, U$192, U$230, U$266, U$304, U$340, U$378, U$414, U$452, U$488, U$526, U$562, U$600, U$636, U$674, U$710: #SCK#5
U$9, U$47, U$83, U$119, U$157, U$193, U$231, U$267, U$305, U$341, U$379, U$415, U$453, U$489, U$527, U$563, U$601, U$637, U$675, U$711: #D1#5
U$10, U$48, U$84, U$120, U$158, U$194, U$232, U$268, U$306, U$342, U$380, U$416, U$454, U$490, U$528, U$564, U$602, U$638, U$676, U$712: #D0#5
U$11, U$49, U$85, U$121, U$159, U$195, U$233, U$269, U$307, U$343, U$381, U$417, U$455, U$491, U$529, U$565, U$603, U$639, U$677, U$713: #PWM0#5
U$12, U$50, U$86, U$122, U$160, U$196, U$234, U$270, U$308, U$344, U$382, U$418, U$456, U$492, U$530, U$566, U$604, U$640, U$678, U$714: #PWM1#5
U$13, U$51, U$87, U$123, U$161, U$197, U$235, U$271, U$309, U$345, U$383, U$419, U$457, U$493, U$531, U$567, U$605, U$641, U$679, U$715: #A1#5
U$14, U$52, U$88, U$124, U$162, U$198, U$236, U$272, U$310, U$346, U$384, U$420, U$458, U$494, U$532, U$568, U$606, U$642, U$680, U$716: #A0#5
U$15, U$53, U$89, U$125, U$163, U$199, U$237, U$273, U$311, U$347, U$385, U$421, U$459, U$495, U$533, U$569, U$607, U$643, U$681, U$717: #GND#4
U$16, U$54, U$90, U$126, U$164, U$200, U$238, U$274, U$312, U$348, U$386, U$422, U$460, U$496, U$534, U$570, U$608, U$644, U$682, U$718: #3#3V#1
U$17, U$55, U$91, U$127, U$165, U$201, U$239, U$275, U$313, U$349, U$387, U$423, U$461, U$497, U$535, U$571, U$609, U$645, U$683, U$719: ##RST##0
U$18, U$66, U$92, U$140, U$166, U$214, U$240, U$288, U$314, U$362, U$388, U$436, U$462, U$510, U$536, U$584, U$610, U$658, U$684, U$732: #MEAS#25
U$19, U$93, U$167, U$241, U$315, U$389, U$463, U$537, U$611, U$685: CHG20
U$20, U$94, U$168, U$242, U$316, U$390, U$464, U$538, U$612, U$686: RESET19
U$21, U$95, U$169, U$243, U$317, U$391, U$465, U$539, U$613, U$687: BOOT18
U$22, U$57, U$96, U$129, U$170, U$203, U$244, U$277, U$318, U$351, U$392, U$425, U$466, U$499, U$540, U$573, U$614, U$647, U$688, U$721: #VBT#16
U$23, U$58, U$97, U$130, U$171, U$204, U$245, U$278, U$319, U$352, U$393, U$426, U$467, U$500, U$541, U$574, U$615, U$648, U$689, U$722: #EN#15
U$24, U$59, U$98, U$131, U$172, U$205, U$246, U$279, U$320, U$353, U$394, U$427, U$468, U$501, U$542, U$575, U$616, U$649, U$690, U$723: #G0#14
U$25, U$60, U$99, U$132, U$173, U$206, U$247, U$280, U$321, U$354, U$395, U$428, U$469, U$502, U$543, U$576, U$617, U$650, U$691, U$724: #G1#14
U$26, U$61, U$100, U$133, U$174, U$207, U$248, U$281, U$322, U$355, U$396, U$429, U$470, U$503, U$544, U$577, U$618, U$651, U$692, U$725: #G2#14
U$27, U$62, U$101, U$134, U$175, U$208, U$249, U$282, U$323, U$356, U$397, U$430, U$471, U$504, U$545, U$578, U$619, U$652, U$693, U$726: #G3#14
U$28, U$63, U$102, U$135, U$176, U$209, U$250, U$283, U$324, U$357, U$398, U$431, U$472, U$505, U$546, U$579, U$620, U$653, U$694, U$727: #G4#14
U$29, U$64, U$103, U$136, U$177, U$210, U$251, U$284, U$325, U$358, U$399, U$432, U$473, U$506, U$547, U$580, U$621, U$654, U$695, U$728: #G5#14
U$30, U$65, U$104, U$137, U$178, U$211, U$252, U$285, U$326, U$359, U$400, U$433, U$474, U$507, U$548, U$581, U$622, U$655, U$696, U$729: #G6#14
U$31, U$105, U$179, U$253, U$327, U$401, U$475, U$549, U$623, U$697: #SCL#13
U$32, U$67, U$106, U$138, U$180, U$212, U$254, U$286, U$328, U$360, U$402, U$434, U$476, U$508, U$550, U$582, U$624, U$656, U$698, U$730: #SDA#12
U$33, U$107, U$181, U$255, U$329, U$403, U$477, U$551, U$625, U$699: 3#3V22
U$34, U$108, U$182, U$256, U$330, U$404, U$478, U$552, U$626, U$700: VIN21
U$35, U$68, U$109, U$139, U$183, U$213, U$257, U$287, U$331, U$361, U$405, U$435, U$479, U$509, U$553, U$583, U$627, U$657, U$701, U$731: #VUB#15
U$36, U$110, U$184, U$258, U$332, U$406, U$480, U$554, U$628, U$702: THINGPLUS29
U$37, U$111, U$185, U$259, U$333, U$407, U$481, U$555, U$629, U$703: MICROMOD30
U$38, U$112, U$186, U$260, U$334, U$408, U$482, U$556, U$630, U$704: #31
U$39, U$148, U$222, U$296, U$370, U$444, U$518, U$592, U$666, U$740: #33
U$40, U$113, U$187, U$261, U$335, U$409, U$483, U$557, U$631, U$705: #BYP#27
U$41, U$147, U$221, U$295, U$369, U$443, U$517, U$591, U$665, U$739: #VE#16
U$56, U$128, U$202, U$276, U$350, U$424, U$498, U$572, U$646, U$720: ##BOOT##10
U$69, U$141, U$215, U$289, U$363, U$437, U$511, U$585, U$659, U$733: #3#3V_LED#25
U$70, U$143, U$217, U$291, U$365, U$439, U$513, U$587, U$661, U$735: #VIN_LED#25
U$71, U$145, U$219, U$293, U$367, U$441, U$515, U$589, U$663, U$737: #SCL#G7#14
U$72, U$142, U$216, U$290, U$364, U$438, U$512, U$586, U$660, U$734: #I2C#27
U$73, U$146, U$220, U$294, U$368, U$442, U$516, U$590, U$664, U$738: THINGPLUS_MICROMOD29
U$74, U$144, U$218, U$292, U$366, U$440, U$514, U$588, U$662, U$736: #SCL#G7#27
VE, VE1, VE2, VE3, VE4, VE5, VE6, VE7, VE8, VE9: SMT-JUMPER_2_NO_SILK
VIN_LED, VIN_LED1, VIN_LED2, VIN_LED3, VIN_LED4, VIN_LED5, VIN_LED6, VIN_LED7, VIN_LED8, VIN_LED9: SMT-JUMPER_2_NC_TRACE_SILK

Connections:
3.3V: 3V3_LED.2, C1.2, C2.2, C4.1, C8.1, C9.1, C10.1, J1.2, J1.74, J2.15, J4.VCC, J8.1, JP1.2, R4.2, R5.2, U64.1
3.3V1: 3V3_LED1.2, C20.2, C21.2, C24.1, C27.1, C28.1, C29.1, J9.15, J12.VCC, J13.2, J13.74, J16.1, JP2.2, R14.2, R17.2, U3.1
3.3V2: 3V3_LED2.2, C36.2, C37.2, C40.1, C43.1, C44.1, C45.1, J17.15, J20.VCC, J21.2, J21.74, J24.1, JP3.2, R27.2, R30.2, U7.1
3.3V3: 3V3_LED3.2, C52.2, C53.2, C56.1, C59.1, C60.1, C61.1, J25.15, J28.VCC, J29.2, J29.74, J32.1, JP4.2, R40.2, R43.2, U11.1
3.3V4: 3V3_LED4.2, C68.2, C69.2, C72.1, C75.1, C76.1, C77.1, J33.15, J36.VCC, J37.2, J37.74, J40.1, JP5.2, R53.2, R56.2, U15.1
3.3V5: 3V3_LED5.2, C84.2, C85.2, C88.1, C91.1, C92.1, C93.1, J41.15, J44.VCC, J45.2, J45.74, J48.1, JP6.2, R66.2, R69.2, U19.1
3.3V6: 3V3_LED6.2, C100.2, C101.2, C104.1, C107.1, C108.1, C109.1, J49.15, J52.VCC, J53.2, J53.74, J56.1, JP7.2, R79.2, R82.2, U23.1
3.3V7: 3V3_LED7.2, C116.2, C117.2, C120.1, C123.1, C124.1, C125.1, J57.15, J60.VCC, J61.2, J61.74, J64.1, JP8.2, R92.2, R95.2, U28.1
3.3V8: 3V3_LED8.2, C132.2, C133.2, C136.1, C139.1, C140.1, C141.1, J65.15, J68.VCC, J69.2, J69.74, J72.1, JP9.2, R105.2, R108.2, U32.1
3.3V9: 3V3_LED9.2, C148.2, C149.2, C152.1, C155.1, C156.1, C157.1, J73.15, J76.VCC, J77.2, J77.74, J80.1, JP10.2, R118.2, R121.2, U37.1
3.3V_EN_VE: D1.C, R3.1, U64.5, VE.2
3.3V_EN_VE1: D7.C, R20.1, U3.5, VE1.2
3.3V_EN_VE2: D13.C, R33.1, U7.5, VE2.2
3.3V_EN_VE3: D19.C, R46.1, U11.5, VE3.2
3.3V_EN_VE4: D25.C, R59.1, U15.5, VE4.2
3.3V_EN_VE5: D31.C, R72.1, U19.5, VE5.2
3.3V_EN_VE6: D37.C, R85.1, U23.5, VE6.2
3.3V_EN_VE7: D43.C, R98.1, U28.5, VE7.2
3.3V_EN_VE8: D49.C, R111.1, U32.5, VE8.2
3.3V_EN_VE9: D55.C, R124.1, U37.5, VE9.2
!BOOT!: J1.11, J2.1, S2.3, S2.4
!BOOT!1: J9.1, J13.11, S4.3, S4.4
!BOOT!2: J17.1, J21.11, S6.3, S6.4
!BOOT!3: J25.1, J29.11, S8.3, S8.4
!BOOT!4: J33.1, J37.11, S10.3, S10.4
!BOOT!5: J41.1, J45.11, S12.3, S12.4
!BOOT!6: J49.1, J53.11, S14.3, S14.4
!BOOT!7: J57.1, J61.11, S16.3, S16.4
!BOOT!8: J65.1, J69.11, S18.3, S18.4
!BOOT!9: J73.1, J77.11, S20.3, S20.4
!I2C_INT!: J1.16, R4.1, U34.5
!I2C_INT!1: J13.16, R17.1, U1.5
!I2C_INT!2: J21.16, R30.1, U5.5
!I2C_INT!3: J29.16, R43.1, U9.5
!I2C_INT!4: J37.16, R56.1, U13.5
!I2C_INT!5: J45.16, R69.1, U17.5
!I2C_INT!6: J53.16, R82.1, U21.5
!I2C_INT!7: J61.16, R95.1, U25.5
!I2C_INT!8: J69.16, R108.1, U30.5
!I2C_INT!9: J77.16, R121.1, U35.5
!RST!: J1.6, J2.16, J8.10, S1.3, S1.4
!RST!1: J9.16, J13.6, J16.10, S3.3, S3.4
!RST!2: J17.16, J21.6, J24.10, S5.3, S5.4
!RST!3: J25.16, J29.6, J32.10, S7.3, S7.4
!RST!4: J33.16, J37.6, J40.10, S9.3, S9.4
!RST!5: J41.16, J45.6, J48.10, S11.3, S11.4
!RST!6: J49.16, J53.6, J56.10, S13.3, S13.4
!RST!7: J57.16, J61.6, J64.10, S15.3, S15.4
!RST!8: J65.16, J69.6, J72.10, S17.3, S17.4
!RST!9: J73.16, J77.6, J80.10, S19.3, S19.4
!SD_CS!: J1.55, J4.CS/DAT3
!SD_CS!1: J12.CS/DAT3, J13.55
!SD_CS!2: J20.CS/DAT3, J21.55
!SD_CS!3: J28.CS/DAT3, J29.55
!SD_CS!4: J36.CS/DAT3, J37.55
!SD_CS!5: J44.CS/DAT3, J45.55
!SD_CS!6: J52.CS/DAT3, J53.55
!SD_CS!7: J60.CS/DAT3, J61.55
!SD_CS!8: J68.CS/DAT3, J69.55
!SD_CS!9: J76.CS/DAT3, J77.55
A0: J1.34, J2.12
A1: J1.38, J2.11
A2: J9.12, J13.34
A3: J9.11, J13.38
A4: J17.12, J21.34
A5: J17.11, J21.38
A6: J25.12, J29.34
A7: J25.11, J29.38
A8: J33.12, J37.34
A9: J33.11, J37.38
A10: J41.12, J45.34
A11: J41.11, J45.38
A12: J49.12, J53.34
A13: J49.11, J53.38
A14: J57.12, J61.34
A15: J57.11, J61.38
A16: J65.12, J69.34
A17: J65.11, J69.38
A18: J73.12, J77.34
A19: J73.11, J77.38
BATT_VIN/1: J13.49, R18.2, R19.1
BATT_VIN/2: J21.49, R31.2, R32.1
BATT_VIN/3: J1.49, R10.1, R11.2
BATT_VIN/4: J29.49, R44.2, R45.1
BATT_VIN/5: J37.49, R57.2, R58.1
BATT_VIN/6: J45.49, R70.2, R71.1
BATT_VIN/7: J53.49, R83.2, R84.1
BATT_VIN/8: J61.49, R96.2, R97.1
BATT_VIN/9: J69.49, R109.2, R110.1
BATT_VIN/10: J77.49, R122.2, R123.1
CHG_LED: R7.1, U27.1
CHG_LED1: R26.1, U4.1
CHG_LED2: R39.1, U8.1
CHG_LED3: R52.1, U12.1
CHG_LED4: R65.1, U16.1
CHG_LED5: R78.1, U20.1
CHG_LED6: R91.1, U24.1
CHG_LED7: R104.1, U29.1
CHG_LED8: R117.1, U33.1
CHG_LED9: R130.1, U38.1
D0: J1.10, J2.8
D1: J1.18, J2.7
D2: J9.8, J13.10
D3: J9.7, J13.18
D4: J17.8, J21.10
D5: J17.7, J21.18
D6: J25.8, J29.10
D7: J25.7, J29.18
D8: J33.8, J37.10
D9: J33.7, J37.18
D10: J41.8, J45.10
D11: J41.7, J45.18
D12: J49.8, J53.10
D13: J49.7, J53.18
D14: J57.8, J61.10
D15: J57.7, J61.18
D16: J65.8, J69.10
D17: J65.7, J69.18
D18: J73.8, J77.10
D19: J73.7, J77.18
EN: J1.4, J3.11, VE.1
EN1: J10.11, J13.4, VE1.1
EN2: J18.11, J21.4, VE2.1
EN3: J26.11, J29.4, VE3.1
EN4: J34.11, J37.4, VE4.1
EN5: J42.11, J45.4, VE5.1
EN6: J50.11, J53.4, VE6.1
EN7: J58.11, J61.4, VE7.1
EN8: J66.11, J69.4, VE8.1
EN9: J74.11, J77.4, VE9.1
G0: J1.40, J3.9
G1: J1.42, J3.8
G2: J1.44, J3.7
G3: J1.46, J3.6
G4: J1.48, J3.5
G5: J1.73, J3.4
G6: J1.71, J3.3
G7: J1.69, SCL/G7.1
G8: J10.9, J13.40
G9: J10.8, J13.42
G10: J10.6, J13.46
G11: J10.3, J13.71
G12: J10.4, J13.73
G13: J10.5, J13.48
G14: J10.7, J13.44
G15: J13.69, SCL/G1.1
G16: J18.9, J21.40
G17: J18.8, J21.42
G18: J18.6, J21.46
G19: J18.3, J21.71
G20: J18.4, J21.73
G21: J18.5, J21.48
G22: J18.7, J21.44
G23: J21.69, SCL/G2.1
G24: J26.9, J29.40
G25: J26.8, J29.42
G26: J26.6, J29.46
G27: J26.3, J29.71
G28: J26.4, J29.73
G29: J26.5, J29.48
G30: J26.7, J29.44
G31: J29.69, SCL/G3.1
G32: J34.9, J37.40
G33: J34.8, J37.42
G34: J34.6, J37.46
G35: J34.3, J37.71
G36: J34.4, J37.73
G37: J34.5, J37.48
G38: J34.7, J37.44
G39: J37.69, SCL/G4.1
G40: J42.9, J45.40
G41: J42.8, J45.42
G42: J42.6, J45.46
G43: J42.3, J45.71
G44: J42.4, J45.73
G45: J42.5, J45.48
G46: J42.7, J45.44
G47: J45.69, SCL/G5.1
G48: J50.9, J53.40
G49: J50.8, J53.42
G50: J50.6, J53.46
G51: J50.3, J53.71
G52: J50.4, J53.73
G53: J50.5, J53.48
G54: J50.7, J53.44
G55: J53.69, SCL/G6.1
G56: J58.9, J61.40
G57: J58.8, J61.42
G58: J58.6, J61.46
G59: J58.3, J61.71
G60: J58.4, J61.73
G61: J58.5, J61.48
G62: J58.7, J61.44
G63: J61.69, SCL/G8.1
G64: J66.9, J69.40
G65: J66.8, J69.42
G66: J66.6, J69.46
G67: J66.3, J69.71
G68: J66.4, J69.73
G69: J66.5, J69.48
G70: J66.7, J69.44
G71: J69.69, SCL/G9.1
G72: J74.9, J77.40
G73: J74.8, J77.42
G74: J74.6, J77.46
G75: J74.3, J77.71
G76: J74.4, J77.73
G77: J74.5, J77.48
G78: J74.7, J77.44
G79: J77.69, SCL/G10.1
GND: C1.1, C2.1, C3.2, C4.2, C5.2, C6.2, C7.2, C8.2, C9.2, C10.2, C11.2, C12.2, C13.2, C14.2, C15.2, C16.2, D1.A, D5.C, D6.C, H5.1, J1.1, J1.7, J1.33, J1.36, J1.39, J1.45, J1.75, J2.13, J4.CD1, J4.GND, J4.GND1, J4.GND3, J5.GND, J5.GND2, J5.SHLD1, J5.SHLD2, J5.SHLD3, J5.SHLD4, J6.1, J7.1, J8.3, J8.5, J8.9, R1.1, R2.1, R6.1, R11.1, S1.1, S1.2, S2.1, S2.2, U27.2, U34.1, U34.4, U34.6, U34.9, U44.2, U64.4, U64.EP
GND1: C17.2, C18.2, C19.2, C20.1, C21.1, C22.2, C23.2, C24.2, C25.2, C26.2, C27.2, C28.2, C29.2, C30.2, C31.2, C32.2, D7.A, D8.C, D9.C, H10.1, J9.13, J11.1, J12.CD1, J12.GND, J12.GND1, J12.GND3, J13.1, J13.7, J13.33, J13.36, J13.39, J13.45, J13.75, J14.GND, J14.GND2, J14.SHLD1, J14.SHLD2, J14.SHLD3, J14.SHLD4, J15.1, J16.3, J16.5, J16.9, R18.1, R23.1, R24.1, R25.1, S3.1, S3.2, S4.1, S4.2, U1.1, U1.4, U1.6, U1.9, U2.2, U3.4, U3.EP, U4.2
GND2: C33.2, C34.2, C35.2, C36.1, C37.1, C38.2, C39.2, C40.2, C41.2, C42.2, C43.2, C44.2, C45.2, C46.2, C47.2, C48.2, D13.A, D14.C, D15.C, H15.1, J17.13, J19.1, J20.CD1, J20.GND, J20.GND1, J20.GND3, J21.1, J21.7, J21.33, J21.36, J21.39, J21.45, J21.75, J22.GND, J22.GND2, J22.SHLD1, J22.SHLD2, J22.SHLD3, J22.SHLD4, J23.1, J24.3, J24.5, J24.9, R31.1, R36.1, R37.1, R38.1, S5.1, S5.2, S6.1, S6.2, U5.1, U5.4, U5.6, U5.9, U6.2, U7.4, U7.EP, U8.2
GND3: C49.2, C50.2, C51.2, C52.1, C53.1, C54.2, C55.2, C56.2, C57.2, C58.2, C59.2, C60.2, C61.2, C62.2, C63.2, C64.2, D19.A, D20.C, D21.C, H20.1, J25.13, J27.1, J28.CD1, J28.GND, J28.GND1, J28.GND3, J29.1, J29.7, J29.33, J29.36, J29.39, J29.45, J29.75, J30.GND, J30.GND2, J30.SHLD1, J30.SHLD2, J30.SHLD3, J30.SHLD4, J31.1, J32.3, J32.5, J32.9, R44.1, R49.1, R50.1, R51.1, S7.1, S7.2, S8.1, S8.2, U9.1, U9.4, U9.6, U9.9, U10.2, U11.4, U11.EP, U12.2
GND4: C65.2, C66.2, C67.2, C68.1, C69.1, C70.2, C71.2, C72.2, C73.2, C74.2, C75.2, C76.2, C77.2, C78.2, C79.2, C80.2, D25.A, D26.C, D27.C, H25.1, J33.13, J35.1, J36.CD1, J36.GND, J36.GND1, J36.GND3, J37.1, J37.7, J37.33, J37.36, J37.39, J37.45, J37.75, J38.GND, J38.GND2, J38.SHLD1, J38.SHLD2, J38.SHLD3, J38.SHLD4, J39.1, J40.3, J40.5, J40.9, R57.1, R62.1, R63.1, R64.1, S9.1, S9.2, S10.1, S10.2, U13.1, U13.4, U13.6, U13.9, U14.2, U15.4, U15.EP, U16.2
GND5: C81.2, C82.2, C83.2, C84.1, C85.1, C86.2, C87.2, C88.2, C89.2, C90.2, C91.2, C92.2, C93.2, C94.2, C95.2, C96.2, D31.A, D32.C, D33.C, H30.1, J41.13, J43.1, J44.CD1, J44.GND, J44.GND1, J44.GND3, J45.1, J45.7, J45.33, J45.36, J45.39, J45.45, J45.75, J46.GND, J46.GND2, J46.SHLD1, J46.SHLD2, J46.SHLD3, J46.SHLD4, J47.1, J48.3, J48.5, J48.9, R70.1, R75.1, R76.1, R77.1, S11.1, S11.2, S12.1, S12.2, U17.1, U17.4, U17.6, U17.9, U18.2, U19.4, U19.EP, U20.2
GND6: C97.2, C98.2, C99.2, C100.1, C101.1, C102.2, C103.2, C104.2, C105.2, C106.2, C107.2, C108.2, C109.2, C110.2, C111.2, C112.2, D37.A, D38.C, D39.C, H35.1, J49.13, J51.1, J52.CD1, J52.GND, J52.GND1, J52.GND3, J53.1, J53.7, J53.33, J53.36, J53.39, J53.45, J53.75, J54.GND, J54.GND2, J54.SHLD1, J54.SHLD2, J54.SHLD3, J54.SHLD4, J55.1, J56.3, J56.5, J56.9, R83.1, R88.1, R89.1, R90.1, S13.1, S13.2, S14.1, S14.2, U21.1, U21.4, U21.6, U21.9, U22.2, U23.4, U23.EP, U24.2
GND7: C113.2, C114.2, C115.2, C116.1, C117.1, C118.2, C119.2, C120.2, C121.2, C122.2, C123.2, C124.2, C125.2, C126.2, C127.2, C128.2, D43.A, D44.C, D45.C, H40.1, J57.13, J59.1, J60.CD1, J60.GND, J60.GND1, J60.GND3, J61.1, J61.7, J61.33, J61.36, J61.39, J61.45, J61.75, J62.GND, J62.GND2, J62.SHLD1, J62.SHLD2, J62.SHLD3, J62.SHLD4, J63.1, J64.3, J64.5, J64.9, R96.1, R101.1, R102.1, R103.1, S15.1, S15.2, S16.1, S16.2, U25.1, U25.4, U25.6, U25.9, U26.2, U28.4, U28.EP, U29.2
GND8: C129.2, C130.2, C131.2, C132.1, C133.1, C134.2, C135.2, C136.2, C137.2, C138.2, C139.2, C140.2, C141.2, C142.2, C143.2, C144.2, D49.A, D50.C, D51.C, H45.1, J65.13, J67.1, J68.CD1, J68.GND, J68.GND1, J68.GND3, J69.1, J69.7, J69.33, J69.36, J69.39, J69.45, J69.75, J70.GND, J70.GND2, J70.SHLD1, J70.SHLD2, J70.SHLD3, J70.SHLD4, J71.1, J72.3, J72.5, J72.9, R109.1, R114.1, R115.1, R116.1, S17.1, S17.2, S18.1, S18.2, U30.1, U30.4, U30.6, U30.9, U31.2, U32.4, U32.EP, U33.2
GND9: C145.2, C146.2, C147.2, C148.1, C149.1, C150.2, C151.2, C152.2, C153.2, C154.2, C155.2, C156.2, C157.2, C158.2, C159.2, C160.2, D55.A, D56.C, D57.C, H50.1, J73.13, J75.1, J76.CD1, J76.GND, J76.GND1, J76.GND3, J77.1, J77.7, J77.33, J77.36, J77.39, J77.45, J77.75, J78.GND, J78.GND2, J78.SHLD1, J78.SHLD2, J78.SHLD3, J78.SHLD4, J79.1, J80.3, J80.5, J80.9, R122.1, R127.1, R128.1, R129.1, S19.1, S19.2, S20.1, S20.2, U35.1, U35.4, U35.6, U35.9, U36.2, U37.4, U37.EP, U38.2
unnamed: 3V3_LED1.1, R21.2
unnamed: JP1.3, R8.2
unnamed: JP1.1, R9.2
unnamed: BYP1.2, D3.A, F1.2
unnamed: CURR_MEAS.1, CURR_MEAS.3, D3.C, D4.C
unnamed: 3V3_LED.1, R12.2
unnamed: D8.A, R21.1
unnamed: R6.2, U27.5
unnamed: D5.A, R12.1
unnamed: R13.2, VIN_LED.1
unnamed: D6.A, R13.1
unnamed: J5.A5, R2.2
unnamed: J5.B5, R1.2
unnamed: D2.C, R7.2
unnamed: R22.2, VIN_LED1.1
unnamed: D9.A, R22.1
unnamed: J14.A5, R23.2
unnamed: J14.B5, R24.2
unnamed: R25.2, U4.5
unnamed: D10.C, R26.2
unnamed: JP2.3, R15.2
unnamed: JP2.1, R16.2
unnamed: BYP2.2, D11.A, F2.2
unnamed: CURR_MEAS1.1, CURR_MEAS1.3, D11.C, D12.C
unnamed: 3V3_LED2.1, R34.2
unnamed: D14.A, R34.1
unnamed: R35.2, VIN_LED2.1
unnamed: D15.A, R35.1
unnamed: J22.A5, R36.2
unnamed: J22.B5, R37.2
unnamed: R38.2, U8.5
unnamed: D16.C, R39.2
unnamed: JP3.3, R28.2
unnamed: JP3.1, R29.2
unnamed: BYP3.2, D17.A, F3.2
unnamed: CURR_MEAS2.1, CURR_MEAS2.3, D17.C, D18.C
unnamed: 3V3_LED3.1, R47.2
unnamed: D20.A, R47.1
unnamed: R48.2, VIN_LED3.1
unnamed: D21.A, R48.1
unnamed: J30.A5, R49.2
unnamed: J30.B5, R50.2
unnamed: R51.2, U12.5
unnamed: D22.C, R52.2
unnamed: JP4.3, R41.2
unnamed: JP4.1, R42.2
unnamed: BYP4.2, D23.A, F4.2
unnamed: CURR_MEAS3.1, CURR_MEAS3.3, D23.C, D24.C
unnamed: 3V3_LED4.1, R60.2
unnamed: D26.A, R60.1
unnamed: R61.2, VIN_LED4.1
unnamed: D27.A, R61.1
unnamed: J38.A5, R62.2
unnamed: J38.B5, R63.2
unnamed: R64.2, U16.5
unnamed: D28.C, R65.2
unnamed: JP5.3, R54.2
unnamed: JP5.1, R55.2
unnamed: BYP5.2, D29.A, F5.2
unnamed: CURR_MEAS4.1, CURR_MEAS4.3, D29.C, D30.C
unnamed: 3V3_LED5.1, R73.2
unnamed: D32.A, R73.1
unnamed: R74.2, VIN_LED5.1
unnamed: D33.A, R74.1
unnamed: J46.A5, R75.2
unnamed: J46.B5, R76.2
unnamed: R77.2, U20.5
unnamed: D34.C, R78.2
unnamed: JP6.3, R67.2
unnamed: JP6.1, R68.2
unnamed: BYP6.2, D35.A, F6.2
unnamed: CURR_MEAS5.1, CURR_MEAS5.3, D35.C, D36.C
unnamed: 3V3_LED6.1, R86.2
unnamed: D38.A, R86.1
unnamed: R87.2, VIN_LED6.1
unnamed: D39.A, R87.1
unnamed: J54.A5, R88.2
unnamed: J54.B5, R89.2
unnamed: R90.2, U24.5
unnamed: D40.C, R91.2
unnamed: JP7.3, R80.2
unnamed: JP7.1, R81.2
unnamed: BYP7.2, D41.A, F7.2
unnamed: CURR_MEAS6.1, CURR_MEAS6.3, D41.C, D42.C
unnamed: 3V3_LED7.1, R99.2
unnamed: D44.A, R99.1
unnamed: R100.2, VIN_LED7.1
unnamed: D45.A, R100.1
unnamed: J62.A5, R101.2
unnamed: J62.B5, R102.2
unnamed: R103.2, U29.5
unnamed: D46.C, R104.2
unnamed: JP8.3, R93.2
unnamed: JP8.1, R94.2
unnamed: BYP8.2, D47.A, F8.2
unnamed: CURR_MEAS7.1, CURR_MEAS7.3, D47.C, D48.C
unnamed: 3V3_LED8.1, R112.2
unnamed: D50.A, R112.1
unnamed: R113.2, VIN_LED8.1
unnamed: D51.A, R113.1
unnamed: J70.A5, R114.2
unnamed: J70.B5, R115.2
unnamed: R116.2, U33.5
unnamed: D52.C, R117.2
unnamed: JP9.3, R106.2
unnamed: JP9.1, R107.2
unnamed: BYP9.2, D53.A, F9.2
unnamed: CURR_MEAS8.1, CURR_MEAS8.3, D53.C, D54.C
unnamed: 3V3_LED9.1, R125.2
unnamed: D56.A, R125.1
unnamed: R126.2, VIN_LED9.1
unnamed: D57.A, R126.1
unnamed: J78.A5, R127.2
unnamed: J78.B5, R128.2
unnamed: R129.2, U38.5
unnamed: D58.C, R130.2
unnamed: JP10.3, R119.2
unnamed: JP10.1, R120.2
unnamed: BYP10.2, D59.A, F10.2
unnamed: CURR_MEAS9.1, CURR_MEAS9.3, D59.C, D60.C
PWM0: J1.32, J2.10
PWM1: J1.47, J2.9
PWM2: J9.10, J13.32
PWM3: J9.9, J13.47
PWM4: J17.10, J21.32
PWM5: J17.9, J21.47
PWM6: J25.10, J29.32
PWM7: J25.9, J29.47
PWM8: J33.10, J37.32
PWM9: J33.9, J37.47
PWM10: J41.10, J45.32
PWM11: J41.9, J45.47
PWM12: J49.10, J53.32
PWM13: J49.9, J53.47
PWM14: J57.10, J61.32
PWM15: J57.9, J61.47
PWM16: J65.10, J69.32
PWM17: J65.9, J69.47
PWM18: J73.10, J77.32
PWM19: J73.9, J77.47
QWIIC_EN: J1.67, R5.1, U44.3
QWIIC_EN1: J13.67, R14.1, U2.3
QWIIC_EN2: J21.67, R27.1, U6.3
QWIIC_EN3: J29.67, R40.1, U10.3
QWIIC_EN4: J37.67, R53.1, U14.3
QWIIC_EN5: J45.67, R66.1, U18.3
QWIIC_EN6: J53.67, R79.1, U22.3
QWIIC_EN7: J61.67, R92.1, U26.3
QWIIC_EN8: J69.67, R105.1, U31.3
QWIIC_EN9: J77.67, R118.1, U36.3
QWIIC_PWR: C13.1, C14.1, J7.2, U44.5
QWIIC_PWR1: C19.1, C23.1, J11.2, U2.5
QWIIC_PWR2: C35.1, C39.1, J19.2, U6.5
QWIIC_PWR3: C51.1, C55.1, J27.2, U10.5
QWIIC_PWR4: C67.1, C71.1, J35.2, U14.5
QWIIC_PWR5: C83.1, C87.1, J43.2, U18.5
QWIIC_PWR6: C99.1, C103.1, J51.2, U22.5
QWIIC_PWR7: C115.1, C119.1, J59.2, U26.5
QWIIC_PWR8: C131.1, C135.1, J67.2, U31.5
QWIIC_PWR9: C147.1, C151.1, J75.2, U36.5
SCL: J1.14, J7.4, R8.1, SCL/G7.3, U34.7
SCL1: J11.4, J13.14, R15.1, SCL/G1.3, U1.7
SCL2: J19.4, J21.14, R28.1, SCL/G2.3, U5.7
SCL3: J27.4, J29.14, R41.1, SCL/G3.3, U9.7
SCL4: J35.4, J37.14, R54.1, SCL/G4.3, U13.7
SCL5: J43.4, J45.14, R67.1, SCL/G5.3, U17.7
SCL6: J51.4, J53.14, R80.1, SCL/G6.3, U21.7
SCL7: J59.4, J61.14, R93.1, SCL/G8.3, U25.7
SCL8: J67.4, J69.14, R106.1, SCL/G9.3, U30.7
SCL9: J75.4, J77.14, R119.1, SCL/G10.3, U35.7
SCL/G1: J10.2, SCL/G1.2
SCL/G2: J18.2, SCL/G2.2
SCL/G3: J26.2, SCL/G3.2
SCL/G4: J34.2, SCL/G4.2
SCL/G5: J42.2, SCL/G5.2
SCL/G6: J50.2, SCL/G6.2
SCL/G7: J3.2, SCL/G7.2
SCL/G8: J58.2, SCL/G8.2
SCL/G9: J66.2, SCL/G9.2
SCL/G10: J74.2, SCL/G10.2
SDA: J1.12, J3.1, J7.3, R9.1, U34.8
SDA1: J10.1, J11.3, J13.12, R16.1, U1.8
SDA2: J18.1, J19.3, J21.12, R29.1, U5.8
SDA3: J26.1, J27.3, J29.12, R42.1, U9.8
SDA4: J34.1, J35.3, J37.12, R55.1, U13.8
SDA5: J42.1, J43.3, J45.12, R68.1, U17.8
SDA6: J50.1, J51.3, J53.12, R81.1, U21.8
SDA7: J58.1, J59.3, J61.12, R94.1, U25.8
SDA8: J66.1, J67.3, J69.12, R107.1, U30.8
SDA9: J74.1, J75.3, J77.12, R120.1, U35.8
SPI_CIPO: J1.61, J2.4, J4.DO/DAT0
SPI_CIPO1: J9.4, J12.DO/DAT0, J13.61
SPI_CIPO2: J17.4, J20.DO/DAT0, J21.61
SPI_CIPO3: J25.4, J28.DO/DAT0, J29.61
SPI_CIPO4: J33.4, J36.DO/DAT0, J37.61
SPI_CIPO5: J41.4, J44.DO/DAT0, J45.61
SPI_CIPO6: J49.4, J52.DO/DAT0, J53.61
SPI_CIPO7: J57.4, J60.DO/DAT0, J61.61
SPI_CIPO8: J65.4, J68.DO/DAT0, J69.61
SPI_CIPO9: J73.4, J76.DO/DAT0, J77.61
SPI_COPI: J1.59, J2.5, J4.DI/CMD
SPI_COPI1: J9.5, J12.DI/CMD, J13.59
SPI_COPI2: J17.5, J20.DI/CMD, J21.59
SPI_COPI3: J25.5, J28.DI/CMD, J29.59
SPI_COPI4: J33.5, J36.DI/CMD, J37.59
SPI_COPI5: J41.5, J44.DI/CMD, J45.59
SPI_COPI6: J49.5, J52.DI/CMD, J53.59
SPI_COPI7: J57.5, J60.DI/CMD, J61.59
SPI_COPI8: J65.5, J68.DI/CMD, J69.59
SPI_COPI9: J73.5, J76.DI/CMD, J77.59
SPI_SCK: J1.57, J2.6, J4.SCLK
SPI_SCK1: J9.6, J12.SCLK, J13.57
SPI_SCK2: J17.6, J20.SCLK, J21.57
SPI_SCK3: J25.6, J28.SCLK, J29.57
SPI_SCK4: J33.6, J36.SCLK, J37.57
SPI_SCK5: J41.6, J44.SCLK, J45.57
SPI_SCK6: J49.6, J52.SCLK, J53.57
SPI_SCK7: J57.6, J60.SCLK, J61.57
SPI_SCK8: J65.6, J68.SCLK, J69.57
SPI_SCK9: J73.6, J76.SCLK, J77.57
SWDCK: J1.21, J8.4
SWDCK1: J13.21, J16.4
SWDCK2: J21.21, J24.4
SWDCK3: J29.21, J32.4
SWDCK4: J37.21, J40.4
SWDCK5: J45.21, J48.4
SWDCK6: J53.21, J56.4
SWDCK7: J61.21, J64.4
SWDCK8: J69.21, J72.4
SWDCK9: J77.21, J80.4
SWDIO: J1.23, J8.2
SWDIO1: J13.23, J16.2
SWDIO2: J21.23, J24.2
SWDIO3: J29.23, J32.2
SWDIO4: J37.23, J40.2
SWDIO5: J45.23, J48.2
SWDIO6: J53.23, J56.2
SWDIO7: J61.23, J64.2
SWDIO8: J69.23, J72.2
SWDIO9: J77.23, J80.2
UART_RX: J1.19, J2.3
UART_RX1: J9.3, J13.19
UART_RX2: J17.3, J21.19
UART_RX3: J25.3, J29.19
UART_RX4: J33.3, J37.19
UART_RX5: J41.3, J45.19
UART_RX6: J49.3, J53.19
UART_RX7: J57.3, J61.19
UART_RX8: J65.3, J69.19
UART_RX9: J73.3, J77.19
UART_TX: J1.17, J2.2
UART_TX1: J9.2, J13.17
UART_TX2: J17.2, J21.17
UART_TX3: J25.2, J29.17
UART_TX4: J33.2, J37.17
UART_TX5: J41.2, J45.17
UART_TX6: J49.2, J53.17
UART_TX7: J57.2, J61.17
UART_TX8: J65.2, J69.17
UART_TX9: J73.2, J77.17
USB_D+: J1.3, J5.A6, J5.B6
USB_D+1: J13.3, J14.A6, J14.B6
USB_D+2: J21.3, J22.A6, J22.B6
USB_D+3: J29.3, J30.A6, J30.B6
USB_D+4: J37.3, J38.A6, J38.B6
USB_D+5: J45.3, J46.A6, J46.B6
USB_D+6: J53.3, J54.A6, J54.B6
USB_D+7: J61.3, J62.A6, J62.B6
USB_D+8: J69.3, J70.A6, J70.B6
USB_D+9: J77.3, J78.A6, J78.B6
USB_D-: J1.5, J5.A7, J5.B7
USB_D-1: J13.5, J14.A7, J14.B7
USB_D-2: J21.5, J22.A7, J22.B7
USB_D-3: J29.5, J30.A7, J30.B7
USB_D-4: J37.5, J38.A7, J38.B7
USB_D-5: J45.5, J46.A7, J46.B7
USB_D-6: J53.5, J54.A7, J54.B7
USB_D-7: J61.5, J62.A7, J62.B7
USB_D-8: J69.5, J70.A7, J70.B7
USB_D-9: J77.5, J78.A7, J78.B7
VIN: C5.1, C6.1, C7.1, C12.1, C16.1, CURR_MEAS.2, CURR_MEAS.4, D2.A, R3.2, U27.4, U44.1, U64.8, VIN_LED.2
VIN1: C18.1, C25.1, C26.1, C31.1, C32.1, CURR_MEAS1.2, CURR_MEAS1.4, D10.A, R20.2, U2.1, U3.8, U4.4, VIN_LED1.2
VIN2: C34.1, C41.1, C42.1, C47.1, C48.1, CURR_MEAS2.2, CURR_MEAS2.4, D16.A, R33.2, U6.1, U7.8, U8.4, VIN_LED2.2
VIN3: C50.1, C57.1, C58.1, C63.1, C64.1, CURR_MEAS3.2, CURR_MEAS3.4, D22.A, R46.2, U10.1, U11.8, U12.4, VIN_LED3.2
VIN4: C66.1, C73.1, C74.1, C79.1, C80.1, CURR_MEAS4.2, CURR_MEAS4.4, D28.A, R59.2, U14.1, U15.8, U16.4, VIN_LED4.2
VIN5: C82.1, C89.1, C90.1, C95.1, C96.1, CURR_MEAS5.2, CURR_MEAS5.4, D34.A, R72.2, U18.1, U19.8, U20.4, VIN_LED5.2
VIN6: C98.1, C105.1, C106.1, C111.1, C112.1, CURR_MEAS6.2, CURR_MEAS6.4, D40.A, R85.2, U22.1, U23.8, U24.4, VIN_LED6.2
VIN7: C114.1, C121.1, C122.1, C127.1, C128.1, CURR_MEAS7.2, CURR_MEAS7.4, D46.A, R98.2, U26.1, U28.8, U29.4, VIN_LED7.2
VIN8: C130.1, C137.1, C138.1, C143.1, C144.1, CURR_MEAS8.2, CURR_MEAS8.4, D52.A, R111.2, U31.1, U32.8, U33.4, VIN_LED8.2
VIN9: C146.1, C153.1, C154.1, C159.1, C160.1, CURR_MEAS9.2, CURR_MEAS9.4, D58.A, R124.2, U36.1, U37.8, U38.4, VIN_LED9.2
V_BATT: C11.1, C15.1, D4.A, J3.12, J6.2, R10.2, U27.3, U34.2, U34.3
V_BATT1: C17.1, C30.1, D12.A, J10.12, J15.2, R19.2, U1.2, U1.3, U4.3
V_BATT2: C33.1, C46.1, D18.A, J18.12, J23.2, R32.2, U5.2, U5.3, U8.3
V_BATT3: C49.1, C62.1, D24.A, J26.12, J31.2, R45.2, U9.2, U9.3, U12.3
V_BATT4: C65.1, C78.1, D30.A, J34.12, J39.2, R58.2, U13.2, U13.3, U16.3
V_BATT5: C81.1, C94.1, D36.A, J42.12, J47.2, R71.2, U17.2, U17.3, U20.3
V_BATT6: C97.1, C110.1, D42.A, J50.12, J55.2, R84.2, U21.2, U21.3, U24.3
V_BATT7: C113.1, C126.1, D48.A, J58.12, J63.2, R97.2, U25.2, U25.3, U29.3
V_BATT8: C129.1, C142.1, D54.A, J66.12, J71.2, R110.2, U30.2, U30.3, U33.3
V_BATT9: C145.1, C158.1, D60.A, J74.12, J79.2, R123.2, U35.2, U35.3, U38.3
V_USB: BYP1.1, C3.1, F1.1, J1.9, J3.10, J5.VBUS1, J5.VBUS2
V_USB1: BYP2.1, C22.1, F2.1, J10.10, J13.9, J14.VBUS1, J14.VBUS2
V_USB2: BYP3.1, C38.1, F3.1, J18.10, J21.9, J22.VBUS1, J22.VBUS2
V_USB3: BYP4.1, C54.1, F4.1, J26.10, J29.9, J30.VBUS1, J30.VBUS2
V_USB4: BYP5.1, C70.1, F5.1, J34.10, J37.9, J38.VBUS1, J38.VBUS2
V_USB5: BYP6.1, C86.1, F6.1, J42.10, J45.9, J46.VBUS1, J46.VBUS2
V_USB6: BYP7.1, C102.1, F7.1, J50.10, J53.9, J54.VBUS1, J54.VBUS2
V_USB7: BYP8.1, C118.1, F8.1, J58.10, J61.9, J62.VBUS1, J62.VBUS2
V_USB8: BYP9.1, C134.1, F9.1, J66.10, J69.9, J70.VBUS1, J70.VBUS2
V_USB9: BYP10.1, C150.1, F10.1, J74.10, J77.9, J78.VBUS1, J78.VBUS2
