sparkfunX/MicroMod_Thing_Plus/(commit log)

2021-01-21 Update SPI net names
    [ThingPlus_Micromod.brd, ThingPlus_Micromod.sch]
2021-01-22 Corrected schematic, board layout WIP
    [ThingPlus_Micromod.brd, ThingPlus_Micromod.sch]
2021-01-25 ThingPlus Micromod board routing WIP
    [ThingPlus_Micromod.brd, ThingPlus_Micromod.sch]
2021-01-29 Preliminary version of routed board.
    [ThingPlus_Micromod.brd, ThingPlus_Micromod.sch]
2021-01-29 Rename SCL/G7 net to SCL.
    [ThingPlus_Micromod.brd, ThingPlus_Micromod.sch]
2021-01-30 Moved components to remove clearance errors; optimized GND and VCC polygons; fixed schematic off-grid components and fixed CamelCasing. TODO: add labels.
    [ThingPlus_Micromod.brd, ThingPlus_Micromod.sch]
2021-02-03 Added buzzard labels to ThingPlus MicroMod
    [ThingPlus_Micromod.brd, ThingPlus_Micromod.sch]
2021-02-03 Updated labeling placement.
    [ThingPlus_Micromod.brd]
2021-02-05 Updated layout per Nathan's recommendations
    [ThingPlus_Micromod.brd, ThingPlus_Micromod.sch]
2021-02-05 Fixed off-grid wire in schematic
    [ThingPlus_Micromod.sch]
2021-02-11 Fixed wrong battery polarity in top silk; panelized design
    [ThingPlus_Micromod-Panel.GBL, ThingPlus_Micromod-Panel.GBO, ThingPlus_Micromod-Panel.GBP, ThingPlus_Micromod-Panel.GBS, ThingPlus_Micromod-Panel.GKO, ThingPlus_Micromod-Panel.GTL, ThingPlus_Micromod-Panel.GTO, ThingPlus_Micromod-Panel.GTP]
2021-02-18 Fixed panel
    [ThingPlus_Micromod-Panel.GBL, ThingPlus_Micromod-Panel.GBO, ThingPlus_Micromod-Panel.GBP, ThingPlus_Micromod-Panel.GBS, ThingPlus_Micromod-Panel.GKO, ThingPlus_Micromod-Panel.GTL, ThingPlus_Micromod-Panel.GTO, ThingPlus_Micromod-Panel.GTP]
2021-03-24 Added BOM
    [bom_output.csv]
2021-05-24 Initial test jig layout - Work in progress
    [ThingPlus_Micromod-BottomJig.brd, ThingPlus_Micromod-BottomJig.sch]
2021-05-25 Preliminary version of test jig bottom board uploaded
    [ThingPlus_Micromod-BottomJig.brd, ThingPlus_Micromod-BottomJig.sch]
2021-05-30 Moved touch pad traces; added missing mounting hole; created top and middle jig boards;
    [ThingPlus_Micromod-BottomJig.brd, ThingPlus_Micromod-BottomJig.sch, ThingPlus_Micromod-MiddleJig.brd, ThingPlus_Micromod-TopJig.brd]
2021-06-03 Added jig number, SKU and board names to test jig.
    [ThingPlus_Micromod-MiddleJig.brd, ThingPlus_Micromod-TopJig.brd]
2021-06-04 Added milling polygons to bottom and middle jig boards; created Gerber files.
    [ThingPlus_Micromod-BottomJig.brd, ThingPlus_Micromod-MiddleJig.brd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]
2021-06-04 Enlarged right board edge per JLCPCB request
    [ThingPlus_Micromod-TopJig.brd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]
2021-07-23 Updated board and middle jig
    [ThingPlus_Micromod-BottomJig.GBL, ThingPlus_Micromod-BottomJig.GBO, ThingPlus_Micromod-BottomJig.GBP, ThingPlus_Micromod-BottomJig.GBS, ThingPlus_Micromod-BottomJig.GKO, ThingPlus_Micromod-BottomJig.GTL, ThingPlus_Micromod-BottomJig.GTO, ThingPlus_Micromod-BottomJig.GTP]
2021-07-26 Added conditional compilation for V10 board version.
