sparkfunX/MicroMod_Thing_Plus/(notices)

Notices in the files:
parts and their libraries:
SparkFun-Jumpers: Licensing: Creative Commons ShareAlike 4.0 International - https://creativecommons.org/licenses/by-sa/4.0
SparkFun-Aesthetics: Released under the Creative Commons Attribution Share-Alike 4.0 License
SparkFun-Aesthetics: https://creativecommons.org/licenses/by-sa/4.0
